javierveras/projectav-telemetry-pdb-2026/hardware/parts-list/imaginary-engineering-v0-bjcbuq6lzvt41.webp

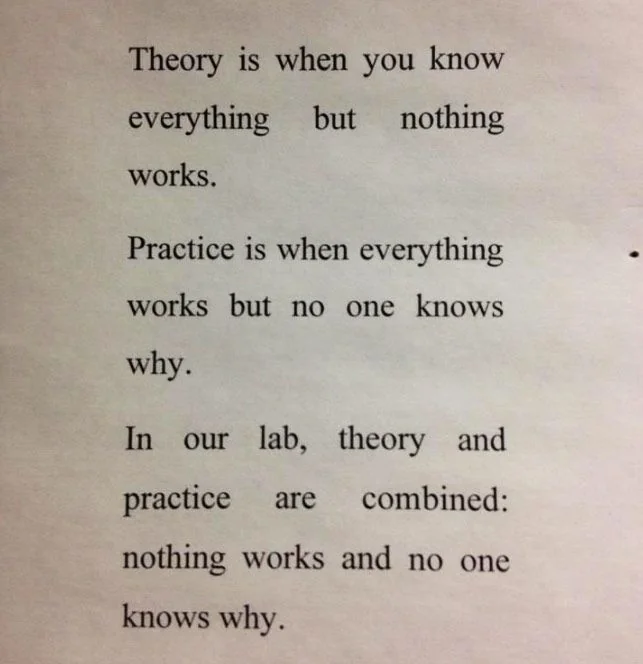
hardware/parts-list/imaginary-engineering-v0-bjcbuq6lzvt41.webp
