javierveras/projectav-telemetry-pdb-2026/hardware/refferences/selected-parts/Screenshot 2026-09-05 142607.png

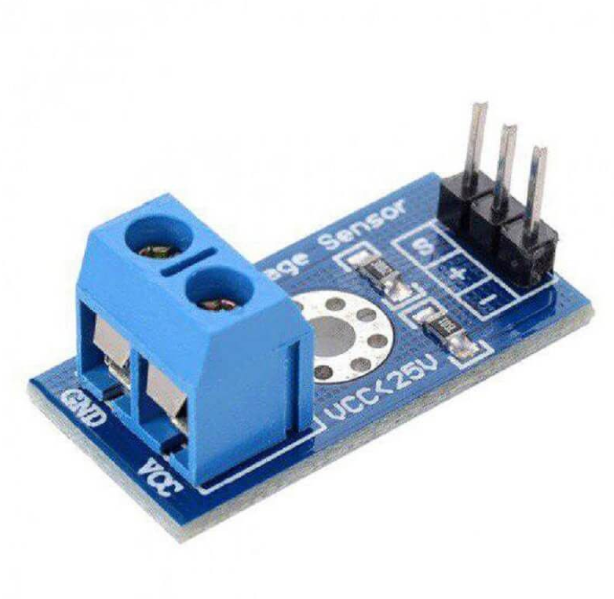
hardware/refferences/selected-parts/Screenshot 2026-09-05 142607.png
