javierveras/projectav-telemetry-pdb-2026/README.md

# Telemetry & Power Distribution System
Our power distribution and telemetry system's hardware, firmware, and technical documentation.
