javierveras/projectav-telemetry-pdb-2026/hardware/mark-II/telemetry-motherboard/data.xlsx

Wheels
Max Wheel Current (A)
15.00
Minnimum Trace Width (top, 2oz), (mm)
7.00
 | e
