javierveras/projectav-telemetry-pdb-2026/docs/gui-concept.png

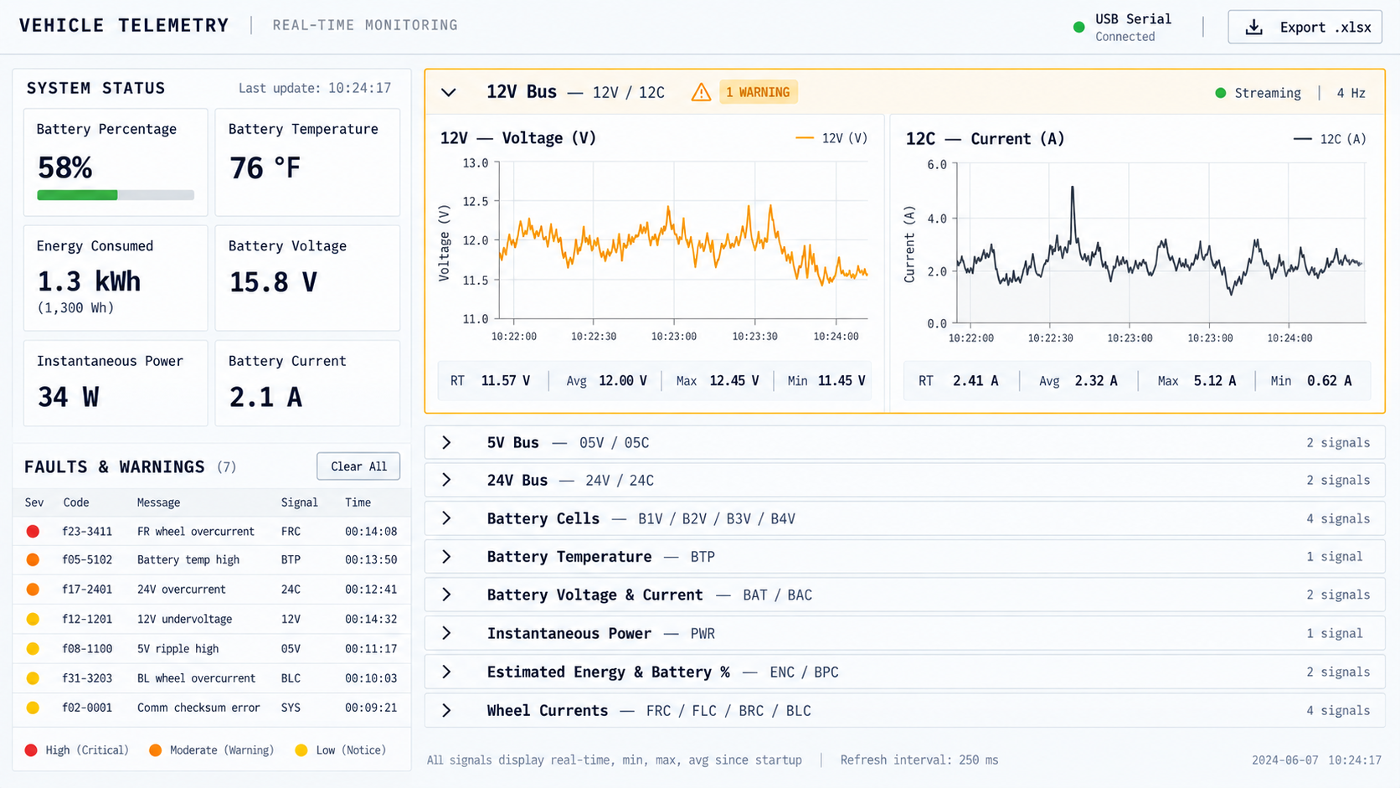
docs/gui-concept.png
