javierveras/projectav-telemetry-pdb-2026/hardware/refferences/projectav-refferences/bms.png

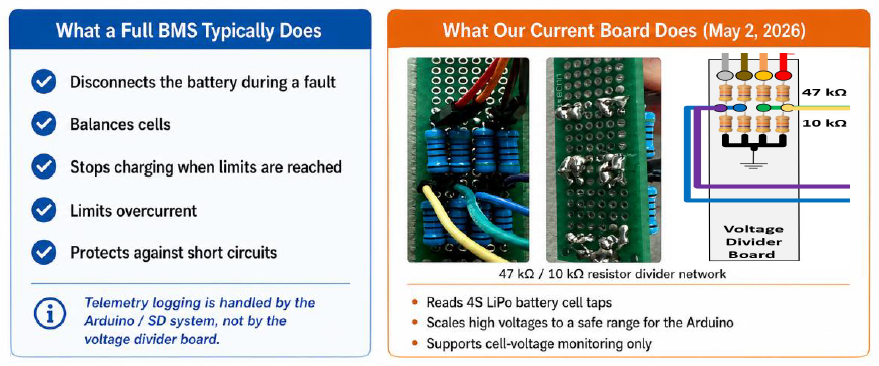
hardware/refferences/projectav-refferences/bms.png
