javierveras/projectav-telemetry-pdb-2026/hardware/refferences/projectav-refferences/jumbletron.jpeg

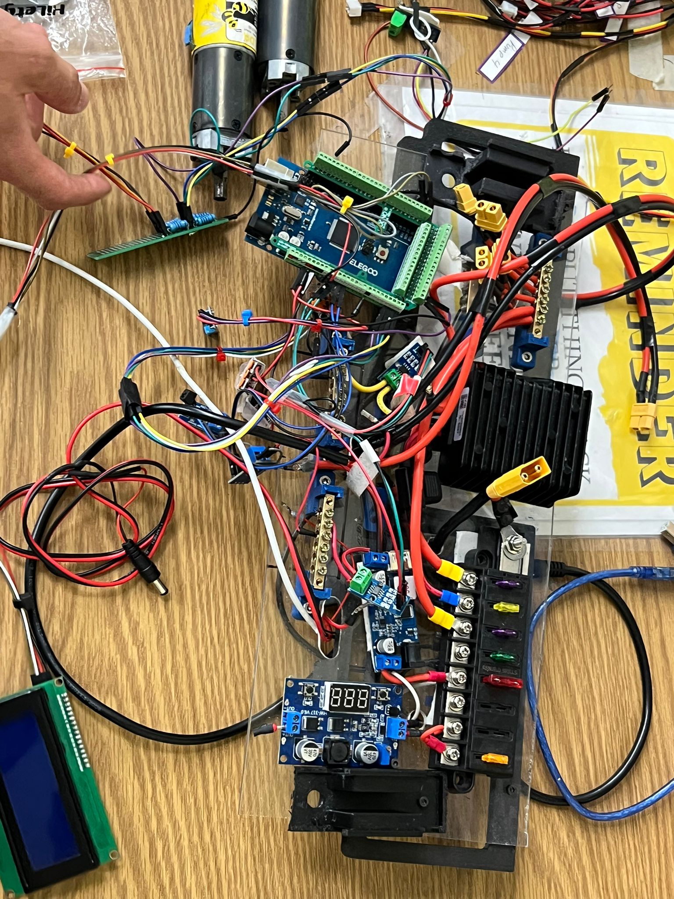
hardware/refferences/projectav-refferences/jumbletron.jpeg
