javierveras/projectav-telemetry-pdb-2026/hardware/bms/bms/excel/Sample-BOM_JLCSMT.xlsx

Comment | Designator | Footprint | JLCPCB Part #（optional）
27K | RTOP1,RTOP2,RTOP3,RTOP4 | R_0805_2012Metric
10K | RBOT1,RBOT2,RBOT3,RBOT4,RBZRPULL | R_0805_2012Metric
680 | RLED1,RLED2,RLED3,RLED4 | R_0805_2012Metric
1K | RBZR | R_0805_2012Metric
Q_NPN_BEC | Q1 | SOT-23
LED | D1,D2,D3,D4 | LED_0805_2012Metric
