javierveras/projectav-telemetry-pdb-2026/hardware/parts-list/5ytykg0xvrzd1.jpeg

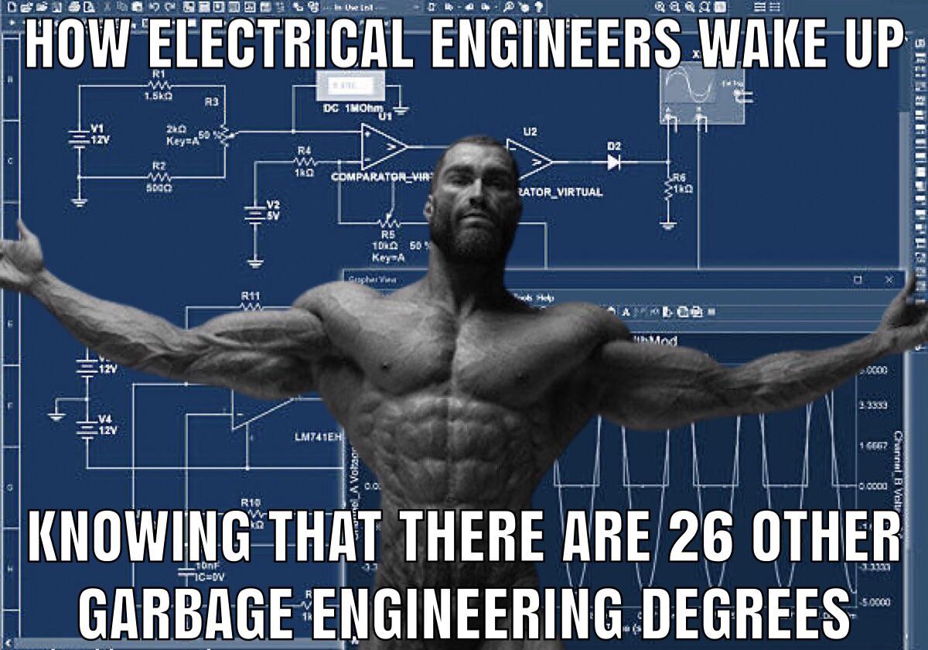
hardware/parts-list/5ytykg0xvrzd1.jpeg
