javierveras/projectav-telemetry-pdb-2026/hardware/parts-list/31UVr6PlqkL.jpg

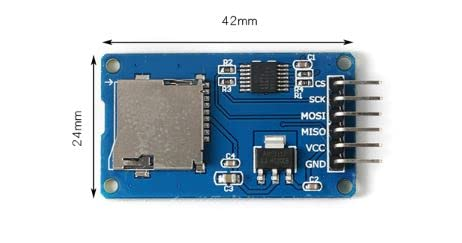
hardware/parts-list/31UVr6PlqkL.jpg
