javierveras/projectav-telemetry-pdb-2026/hardware/refferences/selected-parts/power_input.png

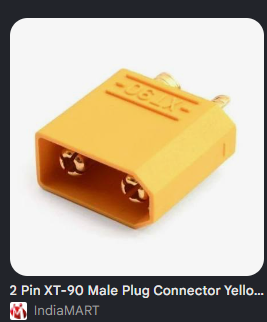
hardware/refferences/selected-parts/power_input.png
