javierveras/projectav-telemetry-pdb-2026/hardware/refferences/selected-parts/power_outputs.png

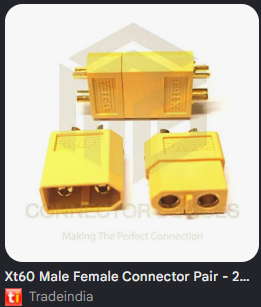
hardware/refferences/selected-parts/power_outputs.png
