javierveras/projectav-telemetry-pdb-2026/hardware/refferences/kicad-refferences/PDB/csense/ACS772ECB-400B-PFF-T.step

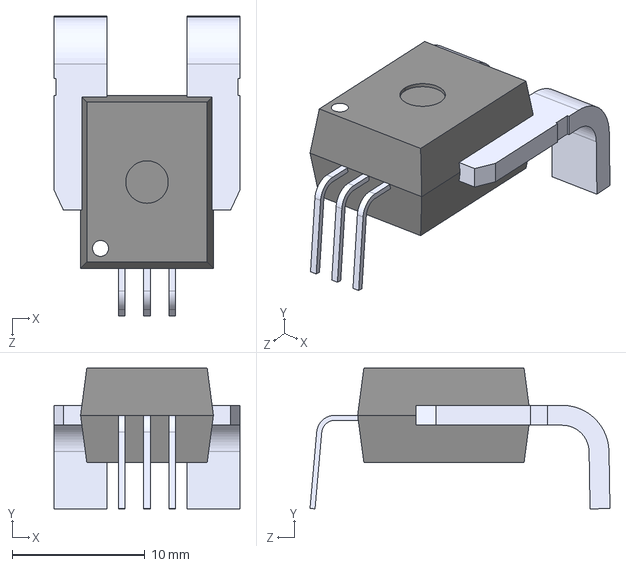
[picture p85: CAD file, 2026-09-18]
hardware/refferences/kicad-refferences/PDB/csense/ACS772ECB-400B-PFF-T.step
14.0 x 10.6 x 22.6 mm
