javierveras/projectav-telemetry-pdb-2026/hardware/refferences/kicad-refferences/PDB/XT90/XT90PW-F/3D/XT90PW-F.stp

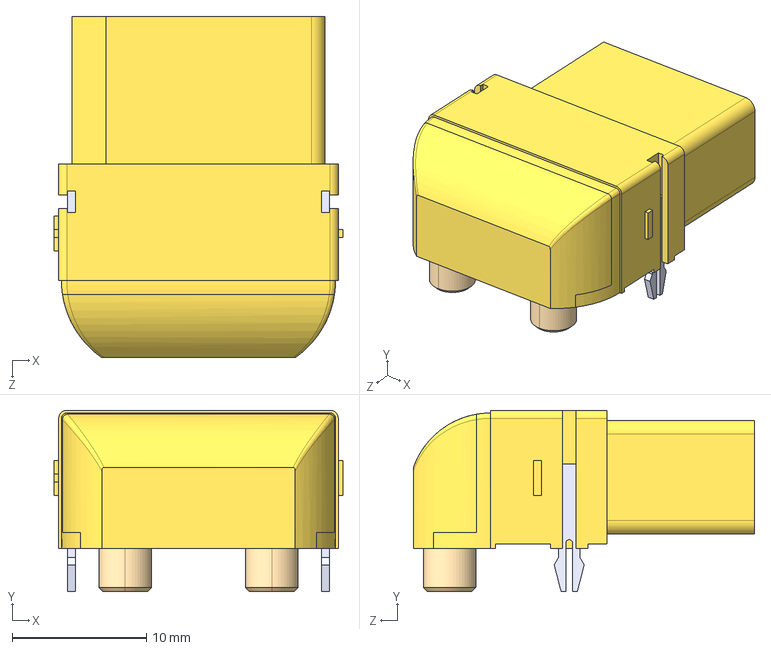
[picture p86: CAD file, 2026-09-18]
hardware/refferences/kicad-refferences/PDB/XT90/XT90PW-F/3D/XT90PW-F.stp
21.5 x 13.5 x 25.4 mm
