javierveras/projectav-telemetry-pdb-2026/hardware/refferences/kicad-refferences/PDB/external_symbols/XT30PW-F.step

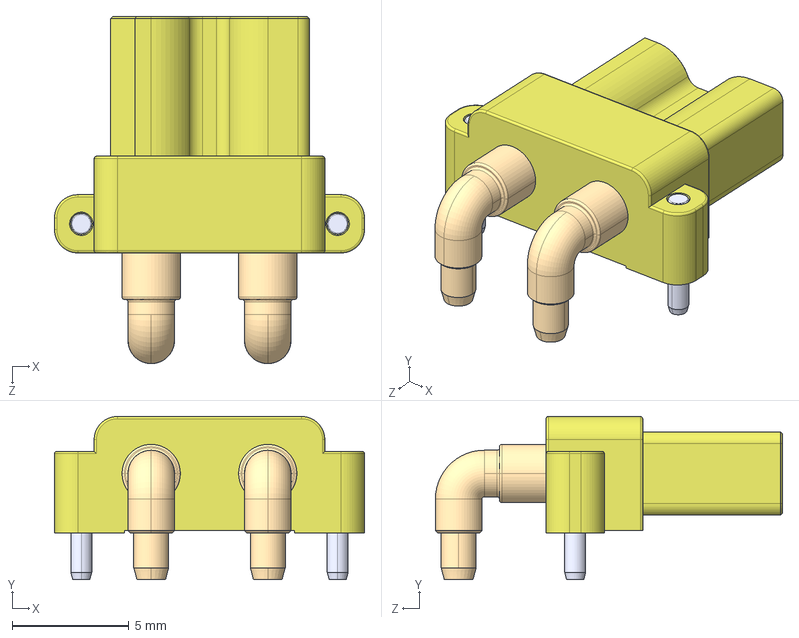
[picture p87: CAD file, 2026-09-18]
hardware/refferences/kicad-refferences/PDB/external_symbols/XT30PW-F.step
13.3 x 7.00 x 14.9 mm
