javierveras/projectav-telemetry-pdb-2026/hardware/refferences/kicad-refferences/PDB/external_symbols/LTC3114EFE-1_PBF.step

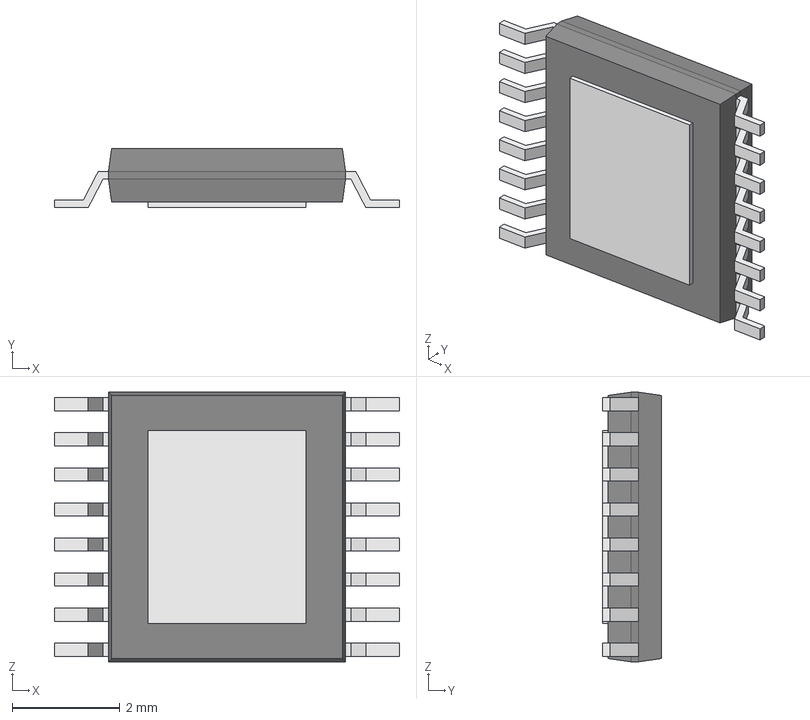
[picture p88: CAD file, 2026-09-18]
hardware/refferences/kicad-refferences/PDB/external_symbols/LTC3114EFE-1_PBF.step
6.40 x 1.10 x 5.00 mm
Body001 (Mirror #1) x 8
