javierveras/projectav-telemetry-pdb-2026/hardware/refferences/kicad-refferences/PDB/external_symbols/XT90PW-M.step

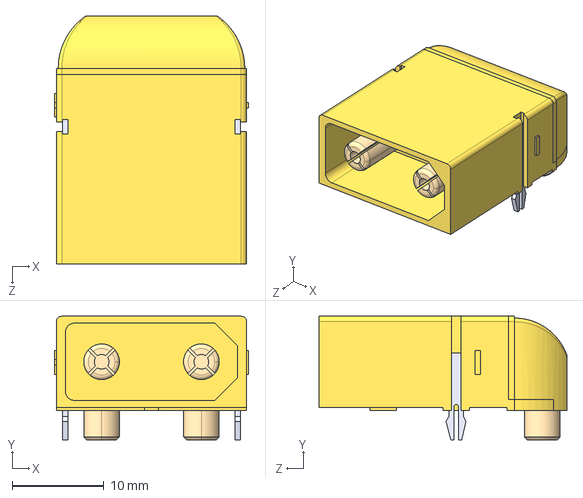
[picture p89: CAD file, 2026-09-18]
hardware/refferences/kicad-refferences/PDB/external_symbols/XT90PW-M.step
21.2 x 13.5 x 27.1 mm
