javierveras/projectav-telemetry-pdb-2026/hardware/refferences/kicad-refferences/PDB/external_symbols/TA08-81GWA.step

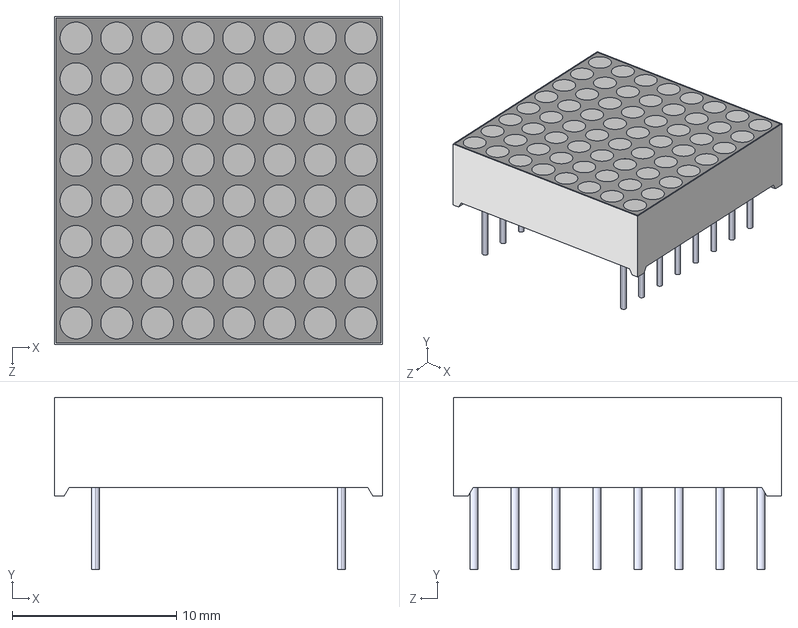
[picture p90: CAD file, 2026-09-18]
hardware/refferences/kicad-refferences/PDB/external_symbols/TA08-81GWA.step
20.0 x 10.5 x 20.0 mm
