javierveras/projectav-telemetry-pdb-2026/hardware/refferences/kicad-refferences/PDB/external_symbols/LI0603G121R-10.step

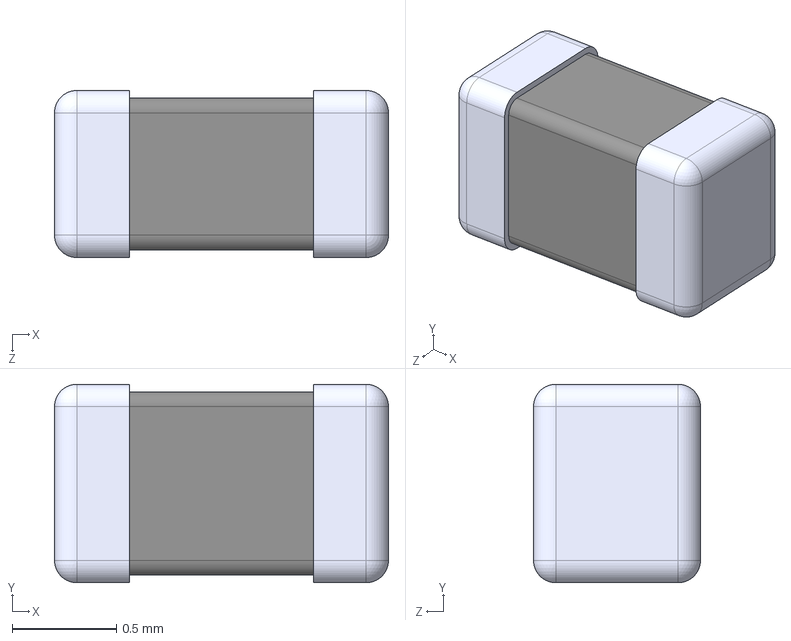
[picture p91: CAD file, 2026-09-18]
hardware/refferences/kicad-refferences/PDB/external_symbols/LI0603G121R-10.step
1.60 x 0.95 x 0.8 mm
