javierveras/projectav-telemetry-pdb-2026/hardware/refferences/kicad-refferences/PDB/external_symbols/AOZ1284PI.step

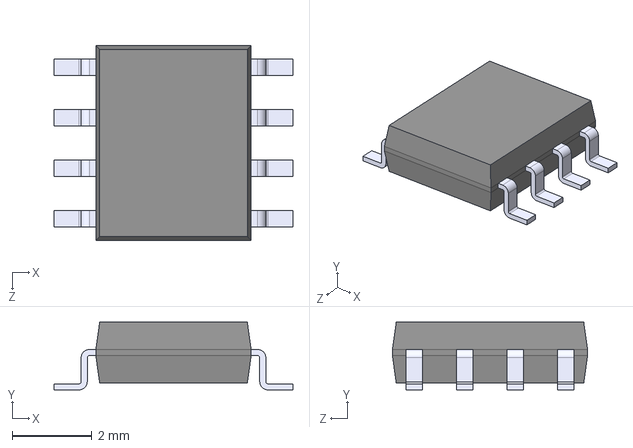
[picture p92: CAD file, 2026-09-18]
hardware/refferences/kicad-refferences/PDB/external_symbols/AOZ1284PI.step
6.00 x 1.70 x 4.90 mm
