javierveras/projectav-telemetry-pdb-2026/hardware/refferences/kicad-refferences/PDB/external_symbols/JS202011SCQN.step

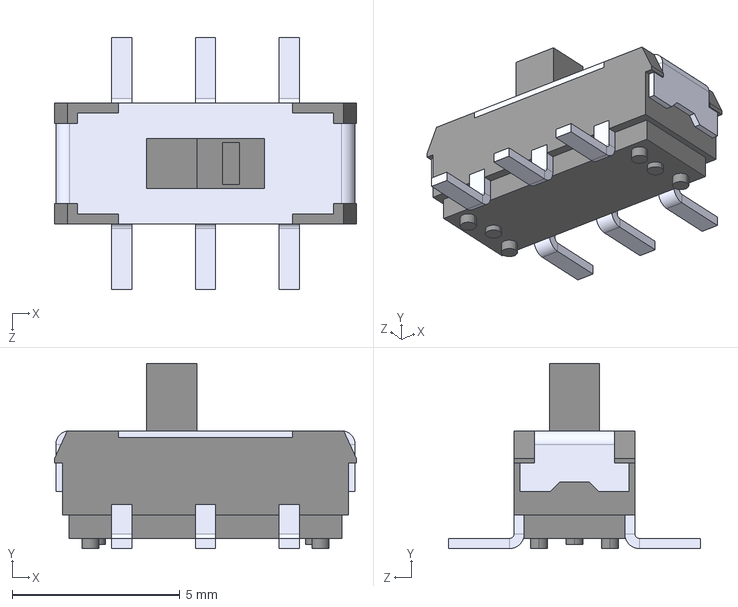
[picture p93: CAD file, 2026-09-18]
hardware/refferences/kicad-refferences/PDB/external_symbols/JS202011SCQN.step
8.99 x 5.51 x 7.49 mm
