javierveras/projectav-telemetry-pdb-2026/hardware/refferences/kicad-refferences/PDB/TLV75533PDBVR/TLV75533PDBVR.step

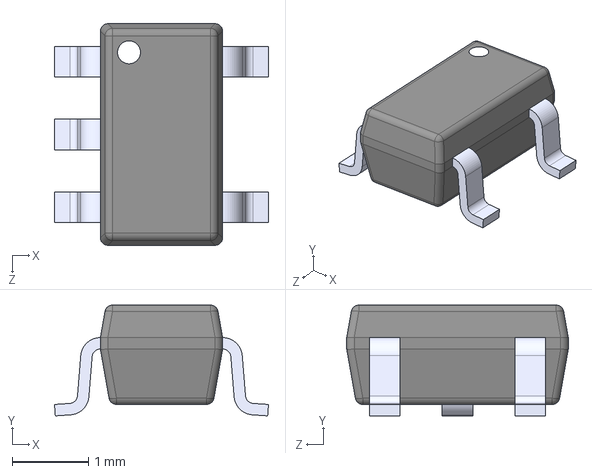
[picture p94: CAD file, 2026-09-18]
hardware/refferences/kicad-refferences/PDB/TLV75533PDBVR/TLV75533PDBVR.step
2.80 x 1.45 x 2.90 mm
