javierveras/projectav-telemetry-pdb-2026/(list of files, cad)

Other CAD files:
hardware/refferences/kicad-refferences/PDB/XT90/XT90PW-F/Allegro/xt90pwf.psm
hardware/refferences/kicad-refferences/PDB/XT90/XT90PW-F/DEHDL/xt90pw_f/chips/chips.prt
