javierveras/projectav-telemetry-pdb-2026/hardware/refferences/projectav-refferences/Electrical System Wiring & Design.pdf

# Antenna

# ESC Mount

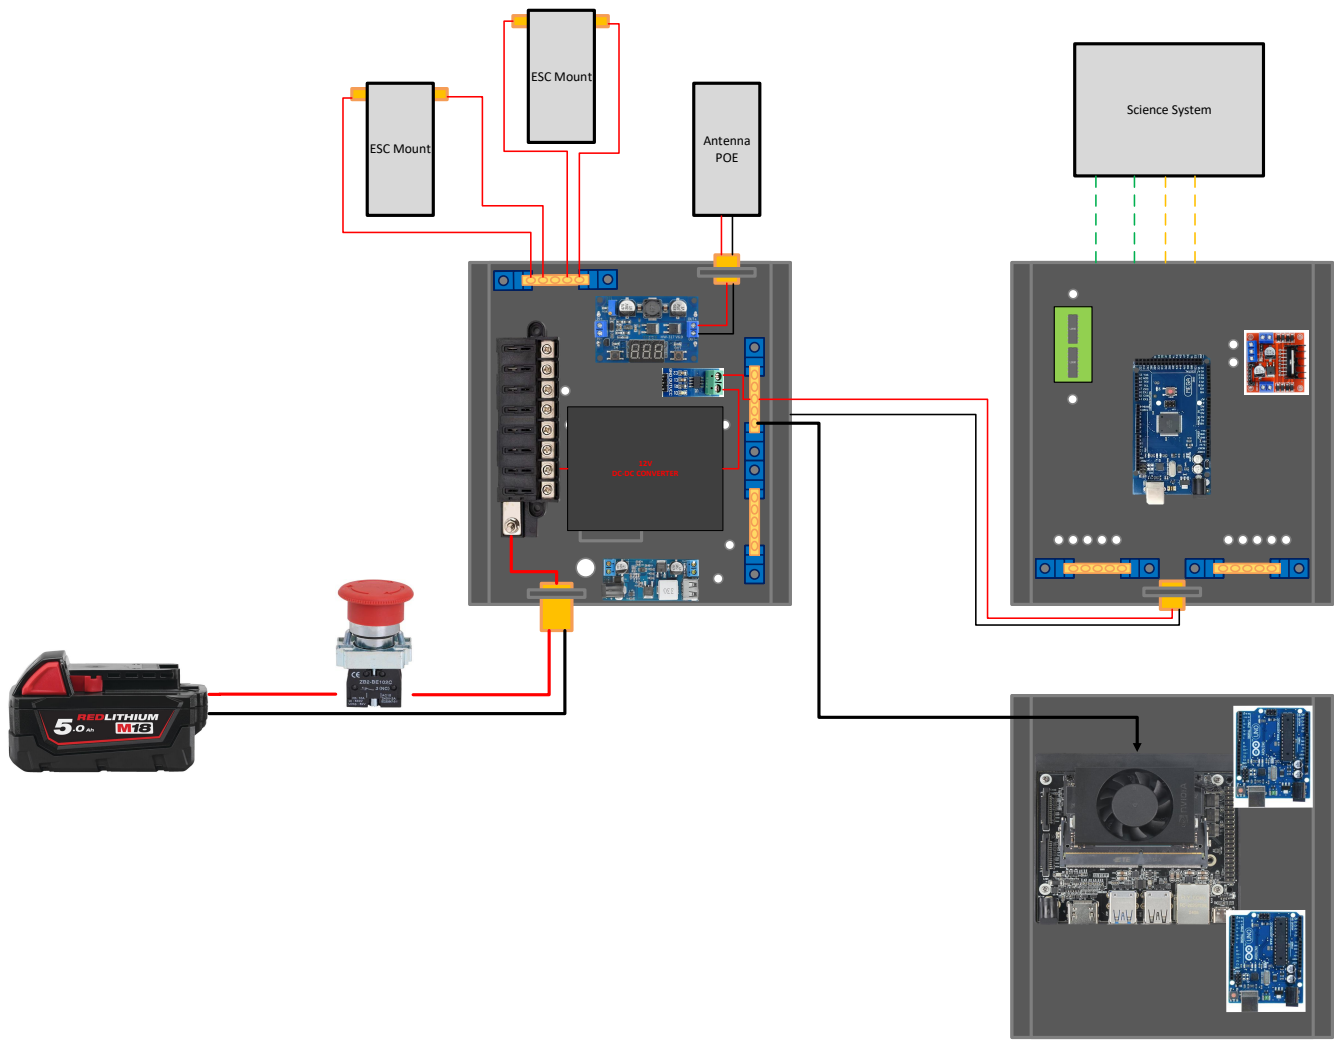
[picture p107: page 1]
Converter; POE; ESC Mount; Science System

DC-DC CONVERTER

Inductor Housing for 12V
