javierveras/projectav-telemetry-pdb-2026/hardware/refferences/projectav-refferences/One-Line Diagram_Rev1.pdf

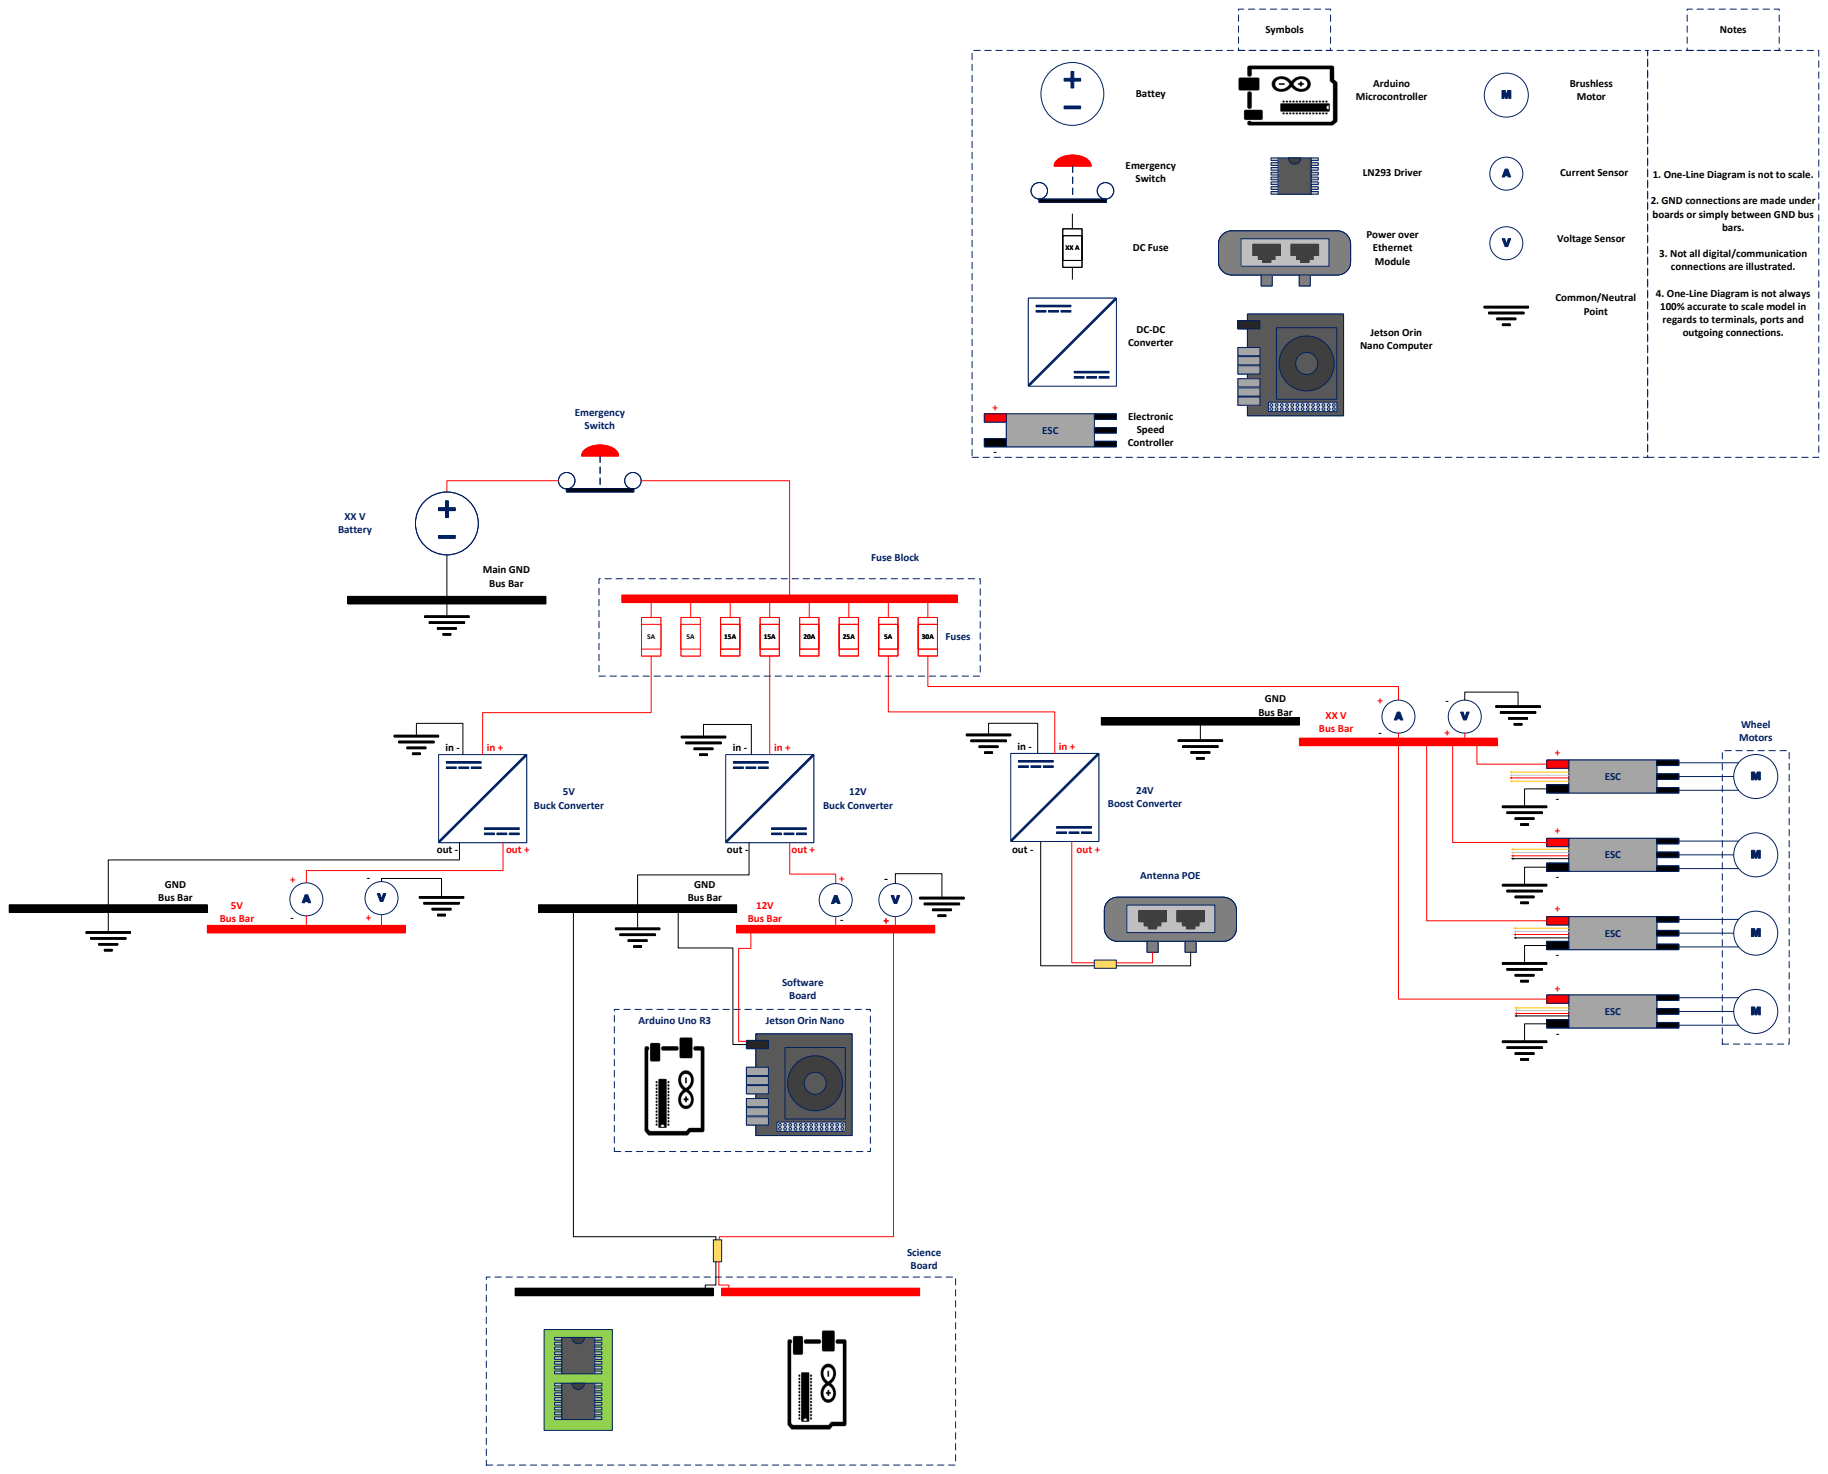
[picture p108: page 1]
ESC; 5V Buck Converter; 12V Buck Converter; 24V Boost Converter; XX V Battery; Emergency Switch; Fuse Block; Main GND Bus Bar; GND Bus Bar; out -; out +; 5V Bus Bar; 12V Bus Bar; Fuses; Wheel Motors; Antenna POE; Software Board; Arduino Uno R3; XX V Bus Bar; Science Board; Symbols; Battey; DC Fuse; DC-DC Converter; Electronic Speed Controller; Arduino Microcontroller; Jetson Orin Nano Computer; LN293 Driver; Power over Ethernet Module; Brushless Motor; Current Sensor; Voltage Sensor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

1. One-Line Diagram is not to scale.

2. GND connections are made under
boards or simply between GND bus

3. Not all digital/communication
connections are illustrated.

4. One-Line Diagram is not always
100% accurate to scale model in
regards to terminals, ports and
outgoing connections.

Jetson Orin Nano
