javierveras/projectav-telemetry-pdb-2026/(list of files, drawings)

Other design files:
hardware/refferences/kicad-refferences/PDB/XT90/XT90PW-F/Altium/XT90PW-F.SchLib
hardware/refferences/kicad-refferences/PDB/XT90/XT90PW-F/Altium/XT90PWF.PcbLib
