javierveras/projectav-telemetry-pdb-2026/hardware/mark-III/telemetry-motherboard/telemetry_mark_I.kicad_pcb

## KiCad design hardware/mark-III/telemetry-motherboard/telemetry_mark_I.kicad_pcb (2026-10-28)

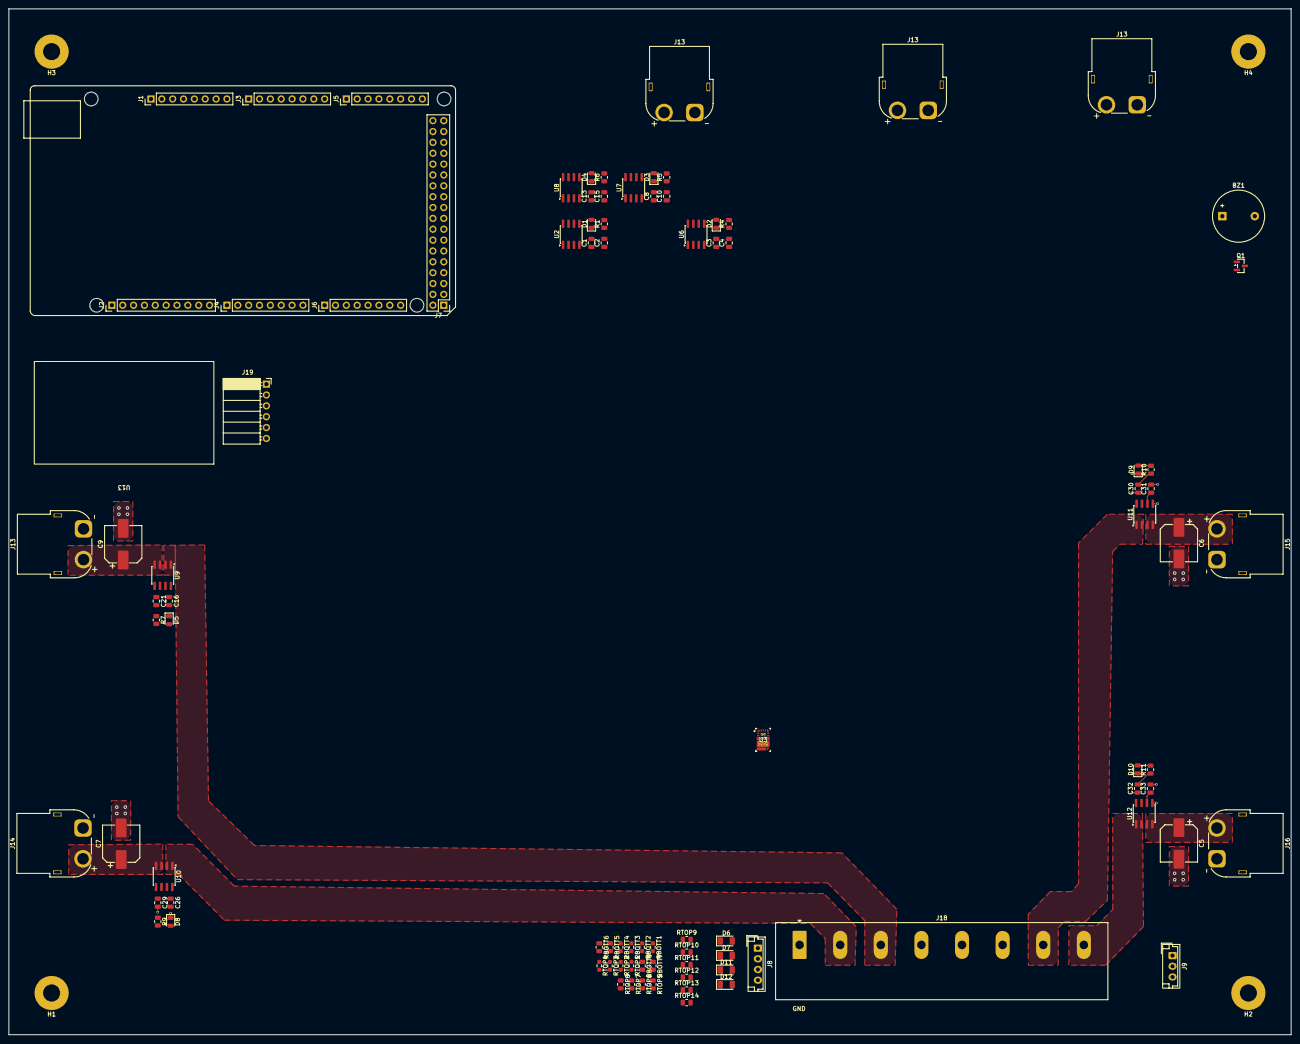
[picture p109: board hardware/mark-III/telemetry-motherboard/telemetry_mark_I.kicad_pcb from above]

Board: 4 copper layers, 300.0 x 240.0 mm, 101 parts (0 on the bottom side), 58 nets.

Parts:
BZ1: Buzzer; Buzzer_12x9.5RM7.6
C1, C3, C8, C13, C16, C26, C30, C32: 100nF; C_0805_2012Metric
C2, C4, C10, C15, C21, C29, C31, C33: 1nF; C_0805_2012Metric
C5, C6, C7, C9: C_Polarized; CP_Elec_8x10.5
D1, D2, D3, D4, D5, D8, D9, D10: LED; LED_0805_2012Metric
D6, D7, D11, D12: LED; LED_1206_3216Metric
H1, H2, H3, H4: MountingHole; MountingHole_4mm_Pad
J1: Power; PinHeader_1x08_P2.54mm_Vertical
J2: PWM; PinHeader_1x10_P2.54mm_Vertical
J3, J5: Analog; PinHeader_1x08_P2.54mm_Vertical
J4: PWM; PinHeader_1x08_P2.54mm_Vertical
J6: Communication; PinHeader_1x08_P2.54mm_Vertical
J7: Digital; PinHeader_2x18_P2.54mm_Vertical
J8: INPUT_CELL1; JST_EH_B4B-EH-A_1x04_P2.50mm_Vertical
J9: Temp_Sensor_Header; JST_EH_B3B-EH-A_1x03_P2.50mm_Vertical
J13, J13#2, J13#3, J13#4, J14, J15, J16: Conn_01x02_Socket; AMASS_XT60PW-F_1x02_P7.20mm_Horizontal
J18: Screw_Terminal_01x08; TerminalBlock_Ningbo-Kagnex_HB9500_1x08_P9.5mm
J19: Conn_01x06_Pin; PinSocket_1x06_P2.54mm_Horizontal
MH1, MH2, MH5, MH6: MountingHole_3.2mm
Q1: Q_NPN_BEC; SOT-23
R1, R4, R5, R6, R7, R9, R10, R11: 1k; R_0805_2012Metric
RBOTT1, RBOTT2, RBOTT3, RBOTT4: 2k; R_0603_1608Metric_Pad0.98x0.95mm_HandSolder
RBOTT5, RBOTT6, RBOTT7, RBOTT8: 10K; R_0805_2012Metric
RTOP1, RTOP2, RTOP3, RTOP4: 18k; R_0603_1608Metric_Pad0.98x0.95mm_HandSolder
RTOP5, RTOP6, RTOP7, RTOP8: 47K; R_0805_2012Metric
RTOP9, RTOP12, RTOP13, RTOP14: 680; R_0805_2012Metric
RTOP10: 1k; R_0805_2012Metric
RTOP11: 10k; R_0805_2012Metric
U1: ArduinoMega
U2, U6, U7, U8, U9, U10, U11, U12: ACS712xLCTR-05B; SOIC-8_3.9x4.9mm_P1.27mm
U3: TPS543B25VRYSR; RYS0017A-MFG
U13: Untitled_3

Connections:
5V_MEASS: J9.1, RTOP4.1, U2.3 (IP-), U2.4 (IP-)
12V_MEASS: RTOP1.1, U6.3 (IP-), U6.4 (IP-)
24V_MEASS: RTOP2.1, U7.3 (IP-), U7.4 (IP-)
+5V: C1.2, C3.2, C8.2, C13.2, C16.2, C26.2, C30.2, C32.2, J1.5, J7.35, J7.36, R1.1, R4.1, R5.1, R6.1, R7.1, R9.1, R10.1, R11.1, U2.1 (IP+), U2.2 (IP+), U2.8 (VCC), U6.8 (VCC), U7.8 (VCC), U8.8 (VCC), U9.8 (VCC), U10.8 (VCC), U11.8 (VCC), U12.8 (VCC)
/5V_CURRENT: J3.1, U2.7 (VIOUT)
/5V_VOLTAGE: RBOTT4.1, RTOP4.2
/12V_CURRENT: J3.2, U6.7 (VIOUT)
/12V_VOLTAGE: RBOTT1.1, RTOP1.2
/24V_CURRENT: J3.3, U7.7 (VIOUT)
/24V_VOLTAGE: RBOTT2.1, RTOP2.2
/+12V: U6.1 (IP+), U6.2 (IP+)
/+24V: U7.1 (IP+), U7.2 (IP+)
/BATT_CURRENT: J3.4, U8.7 (VIOUT)
/BATT_VOLTAGE: RBOTT3.1, RTOP3.2
/BMS/MEASS_CELL1: RBOTT5.1, RTOP5.2
/BMS/MEASS_CELL2: RBOTT7.1, RTOP7.2
/BMS/MEASS_CELL3: RBOTT6.1, RTOP6.2
/BMS/MEASS_CELL4: RBOTT8.1, RTOP8.2
/RAW_BATT(15-ESCs): U8.1 (IP+), U8.2 (IP+)
/RAW_BATT(15-W1): J18.3, U9.1 (IP+), U9.2 (IP+)
/RAW_BATT(15-W2): J18.2, U10.1 (IP+), U10.2 (IP+)
/RAW_BATT(15-W3): J18.7, U11.1 (IP+), U11.2 (IP+)
/RAW_BATT(15-W4): J18.8, U12.1 (IP+), U12.2 (IP+)
/SCL/21: J2.1, J6.8
/SDA/20: J2.2, J6.7
/TEMP_READING: J3.5, J9.2
/W1_MEASS: C9.1, J13.2, J13#4.2, U9.3 (IP-), U9.4 (IP-)
/W2_MEASS: C7.1, J14.2, U10.3 (IP-), U10.4 (IP-)
/W3_MEASS: C6.1, J15.2, U11.3 (IP-), U11.4 (IP-)
/W4_MEASS: C5.1, J16.2, U12.3 (IP-), U12.4 (IP-)
BATT_MEASS: RTOP3.1, U8.3 (IP-), U8.4 (IP-)
GND: C1.1, C2.2, C3.1, C4.2, C5.2, C6.2, C7.2, C8.1, C9.2, C10.2, C13.1, C15.2, C16.1, C21.2, C26.1, C29.2, C30.1, C31.2, C32.1, C33.2, D1.1 (K), D2.1 (K), D3.1 (K), D4.1 (K), D5.1 (K), D6.1 (K), D7.1 (K), D8.1 (K), D9.1 (K), D10.1 (K), D11.1 (K), D12.1 (K), J1.6, J1.7, J2.4, J7.1, J7.2, J9.3, J13.1, J13#4.1, J14.1, J15.1, J16.1, J18.1, Q1.2 (E), RBOTT1.2, RBOTT2.2, RBOTT3.2, RBOTT4.2, RBOTT5.2, RBOTT6.2, RBOTT7.2, RBOTT8.2, RTOP11.1, U2.5 (GND), U6.5 (GND), U7.5 (GND), U8.5 (GND), U9.5 (GND), U10.5 (GND), U11.5 (GND), U12.5 (GND)
unnamed: BZ1.2 (-), Q1.3 (C)
unnamed: D1.2 (A), R1.2
unnamed: D2.2 (A), R4.2
unnamed: D3.2 (A), R5.2
unnamed: D4.2 (A), R6.2
unnamed: D5.2 (A), R7.2
unnamed: D6.2 (A), RTOP9.2
unnamed: D7.2 (A), RTOP13.2
unnamed: D8.2 (A), R9.2
unnamed: D9.2 (A), R10.2
unnamed: D10.2 (A), R11.2
unnamed: D11.2 (A), RTOP12.2
unnamed: D12.2 (A), RTOP14.2
unnamed: Q1.1 (B), RTOP10.2, RTOP11.2
unnamed: C2.1, U2.6 (FILTER)
unnamed: C4.1, U6.6 (FILTER)
unnamed: C10.1, U7.6 (FILTER)
unnamed: C15.1, U8.6 (FILTER)
unnamed: C21.1, U9.6 (FILTER)
unnamed: C29.1, U10.6 (FILTER)
unnamed: C31.1, U11.6 (FILTER)
unnamed: C33.1, U12.6 (FILTER)
RAW_CELL1: J8.1, RTOP5.1
RAW_CELL2: J8.2, RTOP7.1
RAW_CELL3: J8.3, RTOP6.1
RAW_CELL4: J8.4, RTOP8.1
