javierveras/projectav-telemetry-pdb-2026/hardware/bms/bms/bms/bms.kicad_pcb

## KiCad design hardware/bms/bms/bms/bms.kicad_pcb (2026-10-14)

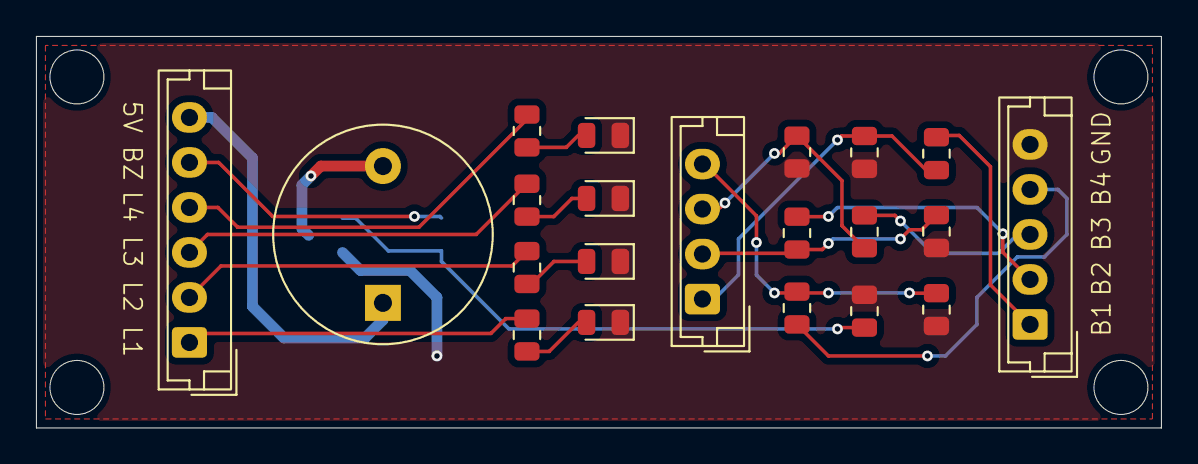
[picture p110: board bms.kicad_pcb from above]

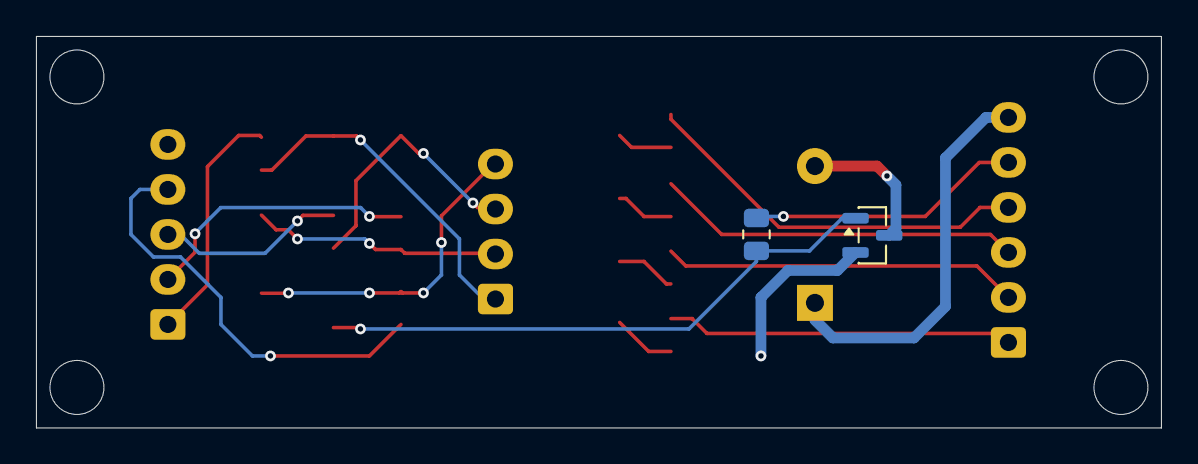
[picture p111: board bms.kicad_pcb from below]

Board: 2 copper layers, 62.5 x 21.8 mm, 23 parts (2 on the bottom side), 21 nets.

Parts:
BZ1: Buzzer; Buzzer_12x9.5RM7.6
D1, D2, D3, D4: LED; LED_0805_2012Metric
J1: OUTPUT; JST_EH_B4B-EH-A_1x04_P2.50mm_Vertical
J2: Conn_01x05_Pin; JST_EH_B5B-EH-A_1x05_P2.50mm_Vertical
J3: Conn_01x06_Pin; JST_EH_B6B-EH-A_1x06_P2.50mm_Vertical
Q1: Q_NPN_BEC; SOT-23
RBOTT5, RBOTT6, RBOTT7, RBOTT8: 10K; R_0805_2012Metric
RTOP5, RTOP6, RTOP7, RTOP8: 47K; R_0805_2012Metric
RTOP9, RTOP12, RTOP13, RTOP14: 680; R_0805_2012Metric
RTOP10: 1k; R_0805_2012Metric
RTOP11: 10k; R_0805_2012Metric

Connections:
/5V: BZ1.1 (+), J3.6
/BUZZER_GATE: J3.5, RTOP10.1
/LED1: J3.1, RTOP9.1
/LED2: J3.2, RTOP13.1
/LED3: J3.3, RTOP14.1
/LED4: J3.4, RTOP12.1
/MEASS_CELL1: J1.1, RBOTT5.1, RTOP5.2
/MEASS_CELL2: J1.2, RBOTT7.1, RTOP7.2
/MEASS_CELL3: J1.3, RBOTT6.1, RTOP6.2
/MEASS_CELL4: J1.4, RBOTT8.1, RTOP8.2
GND: D1.1 (K), D2.1 (K), D3.1 (K), D4.1 (K), J2.5, Q1.2 (E), RBOTT5.2, RBOTT6.2, RBOTT7.2, RBOTT8.2, RTOP11.1
unnamed: BZ1.2 (-), Q1.3 (C)
unnamed: D1.2 (A), RTOP9.2
unnamed: D2.2 (A), RTOP12.2
unnamed: D3.2 (A), RTOP13.2
unnamed: D4.2 (A), RTOP14.2
unnamed: Q1.1 (B), RTOP10.2, RTOP11.2
RAW_CELL1: J2.1, RTOP5.1
RAW_CELL2: J2.2, RTOP7.1
RAW_CELL3: J2.3, RTOP6.1
RAW_CELL4: J2.4, RTOP8.1
