javierveras/projectav-telemetry-pdb-2026/hardware/refferences/kicad-refferences/PDB/pdb.kicad_pcb

## KiCad design hardware/refferences/kicad-refferences/PDB/pdb.kicad_pcb (2026-09-18)

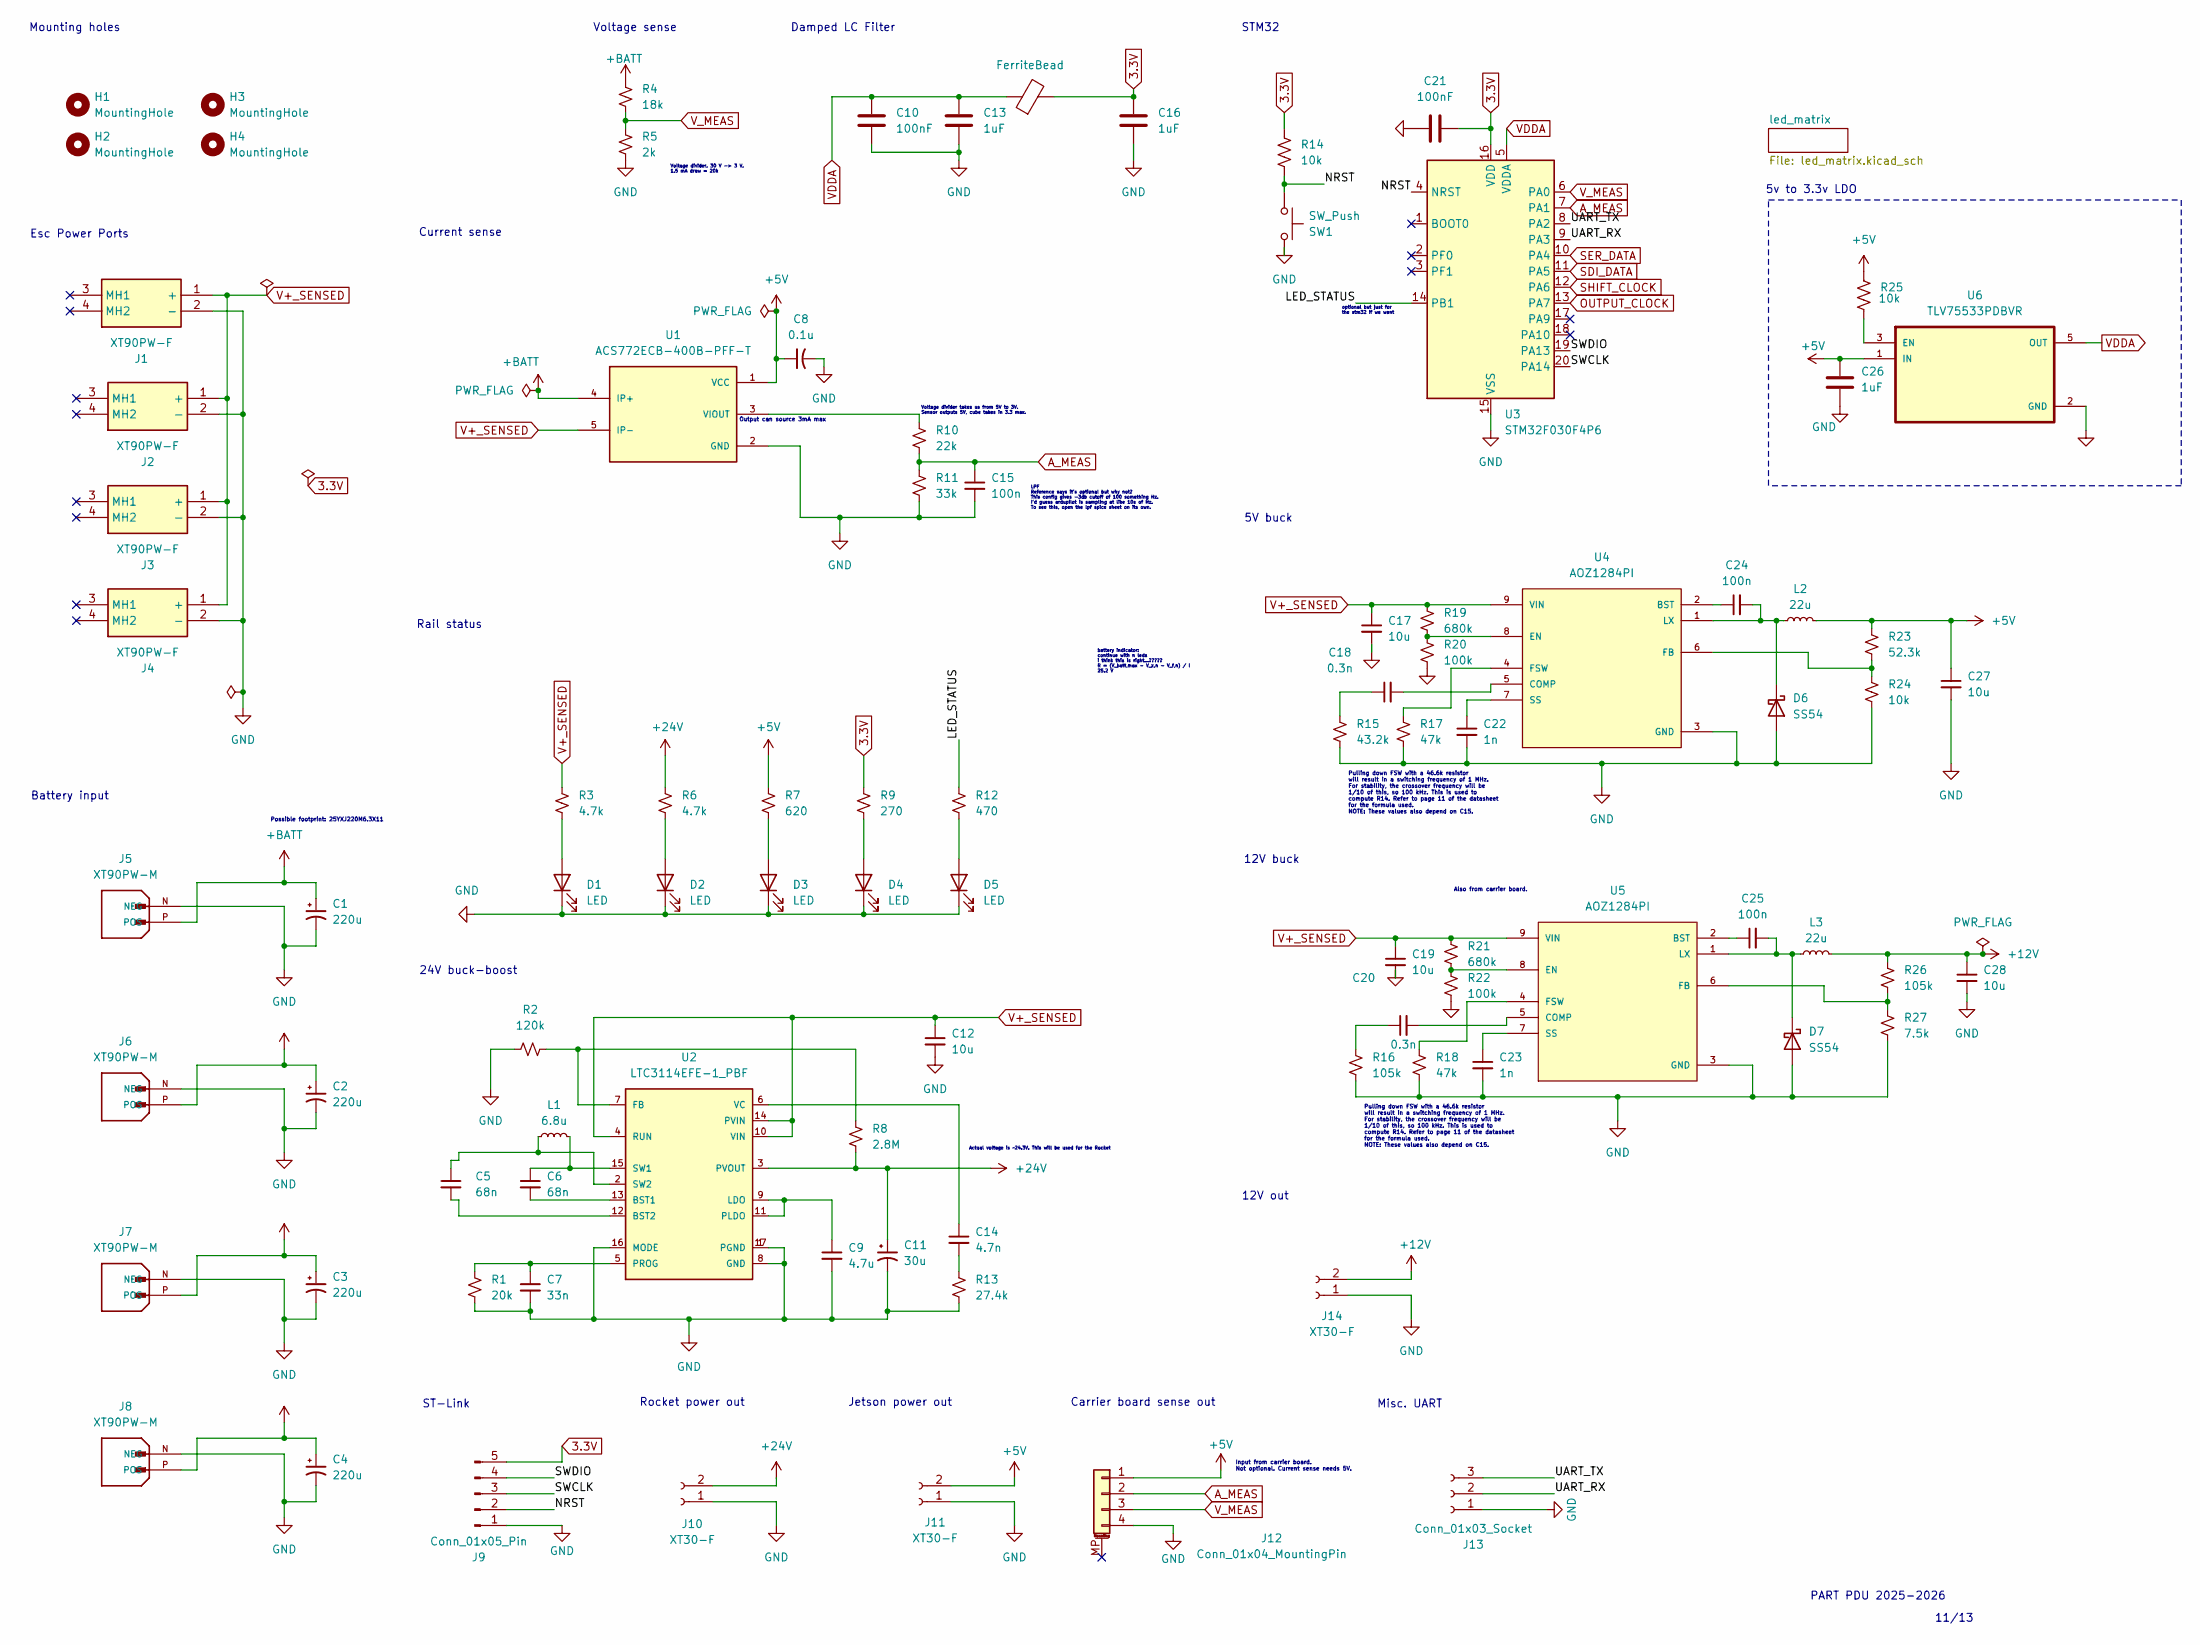
[picture p112: schematic pdb.kicad_sch]

Parts:
C1, C2, C3, C4: 220u; CP_Elec_8x10
C5, C6: 68n; C_0603_1608Metric_Pad1.08x0.95mm_HandSolder
C7: 33n; C_0603_1608Metric_Pad1.08x0.95mm_HandSolder
C8: 0.1u; C_0603_1608Metric_Pad1.08x0.95mm_HandSolder
C9: 4.7u; C_0603_1608Metric_Pad1.08x0.95mm_HandSolder
C10, C21: 100nF; C_0603_1608Metric_Pad1.08x0.95mm_HandSolder
C11: 30u; CP_Radial_D5.0mm_P2.00mm
C12, C17, C19, C27, C28: 10u; C_0603_1608Metric_Pad1.08x0.95mm_HandSolder
C13, C16, C26: 1uF; C_0603_1608Metric_Pad1.08x0.95mm_HandSolder
C14: 4.7n; C_0603_1608Metric_Pad1.08x0.95mm_HandSolder
C15, C24, C25: 100n; C_0603_1608Metric_Pad1.08x0.95mm_HandSolder
C18, C20: 0.3n; C_0603_1608Metric_Pad1.08x0.95mm_HandSolder
C22, C23: 1n; C_0603_1608Metric_Pad1.08x0.95mm_HandSolder
D1, D2, D3, D4, D5: LED; LED_0603_1608Metric_Pad1.05x0.95mm_HandSolder
D6, D7: SS54; D_SMA
FB1: FerriteBead; FB_LI0603G121R-10
H1, H2, H3, H4: MountingHole; MountingHole_4mm_Pad
J1, J2, J3, J4: XT90PW-F; XT90PWF; Manufacturer_Part_Number XT90PW-F
J5, J6, J7, J8: XT90PW-M; AMASS_XT90PW-M; PARTREV V00
J9: Conn_01x05_Pin; PinHeader_1x05_P2.54mm_Vertical
J10, J11, J14: XT30-F; AMASS_XT30PW-F
J12: Conn_01x04_MountingPin; JST_GH_SM04B-GHS-TB_1x04-1MP_P1.25mm_Horizontal
J13: Conn_01x03_Socket; PinSocket_1x03_P2.54mm_Vertical
L1: 6.8u; L_0603_1608Metric_Pad1.05x0.95mm_HandSolder
L2, L3: 22u; L_12x12mm_H8mm
R1: 20k; R_0603_1608Metric_Pad0.98x0.95mm_HandSolder
R2: 120k; R_0603_1608Metric_Pad0.98x0.95mm_HandSolder
R3, R6: 4.7k; R_0603_1608Metric_Pad0.98x0.95mm_HandSolder
R4: 18k; R_0603_1608Metric_Pad0.98x0.95mm_HandSolder
R5: 2k; R_0603_1608Metric_Pad0.98x0.95mm_HandSolder
R7: 620; R_0603_1608Metric_Pad0.98x0.95mm_HandSolder
R8: 2.8M; R_0603_1608Metric_Pad0.98x0.95mm_HandSolder
R9: 270; R_0603_1608Metric_Pad0.98x0.95mm_HandSolder
R10: 22k; R_0603_1608Metric_Pad0.98x0.95mm_HandSolder
R11: 33k; R_0603_1608Metric_Pad0.98x0.95mm_HandSolder
R12: 470; R_0603_1608Metric_Pad0.98x0.95mm_HandSolder
R13: 27.4k; R_0603_1608Metric_Pad0.98x0.95mm_HandSolder
R14, R24, R25: 10k; R_0603_1608Metric_Pad0.98x0.95mm_HandSolder
R15: 43.2k; R_0603_1608Metric_Pad0.98x0.95mm_HandSolder
R16, R26: 105k; R_0603_1608Metric_Pad0.98x0.95mm_HandSolder
R17, R18: 47k; R_0603_1608Metric_Pad0.98x0.95mm_HandSolder
R19, R21: 680k; R_0603_1608Metric_Pad0.98x0.95mm_HandSolder
R20, R22: 100k; R_0603_1608Metric_Pad0.98x0.95mm_HandSolder
R23: 52.3k; R_0603_1608Metric_Pad0.98x0.95mm_HandSolder
R27: 7.5k; R_0603_1608Metric_Pad0.98x0.95mm_HandSolder
SW1: SW_Push; SW_SPST_SKQG_WithStem
U1: ACS772ECB-400B-PFF-T; XDCR_ACS772ECB-400B-PFF-T; PARTREV 21
U2: LTC3114EFE-1_PBF; SOP65P640X110-17N
U3: STM32F030F4P6; TSSOP-20_4.4x6.5mm_P0.65mm
U4, U5: AOZ1284PI; SOP127P600X170-9N; PARTREV 0.5
U6: TLV75533PDBVR; SOT95P280X145-5N

Connections:
3.3V: C16.1, C21.2, FB1.2, J9.5, R9.1, R14.1, U3.16 (VDD); also elsewhere on the board
+5V: C8.1, C26.1, C27.1, J11.2, J12.1, L2.2, R7.1, R23.1, R25.1, U1.1 (VCC), U6.1 (IN)
+12V: C28.1, J14.2, L3.2, R26.1
+24V: C11.1, J10.2, R6.1, R8.2, U2.3 (PVOUT)
+BATT: C1.1, C2.1, C3.1, C4.1, J5.P (POS), J6.P (POS), J7.P (POS), J8.P (POS), R4.1, U1.4 (IP+)
/LED_STATUS: R12.1, U3.14 (PB1)
/NRST: J9.2, R14.2, SW1.2, U3.4 (NRST)
/SWCLK: J9.3, U3.20 (PA14)
/SWDIO: J9.4, U3.19 (PA13)
/UART_RX: J13.2, U3.9 (PA3)
/UART_TX: J13.3, U3.8 (PA2)
A_MEAS: C15.1, J12.2, R10.2, R11.1, U3.7 (PA1)
GND: C1.2, C2.2, C3.2, C4.2, C7.2, C8.2, C9.2, C10.2, C11.2, C12.2, C13.2, C15.2, C16.2, C17.2, C19.2, C21.1, C22.2, C23.2, C26.2, C27.2, C28.2, D1.1 (K), D2.1 (K), D3.1 (K), D4.1 (K), D5.1 (K), D6.2 (A), D7.2 (A), J1.2 (-), J2.2 (-), J3.2 (-), J4.2 (-), J5.N (NEG), J6.N (NEG), J7.N (NEG), J8.N (NEG), J9.1, J10.1, J11.1, J12.4, J13.1, J14.1, R1.2, R2.1, R5.2, R11.2, R13.2, R15.2, R16.2, R17.2, R18.2, R20.2, R22.2, R24.2, R27.2, SW1.1, U1.2 (GND), U2.1 (PGND), U2.8 (GND), U2.16 (MODE), U2.17 (PGND), U3.15 (VSS), U4.3 (GND), U5.3 (GND), U6.2 (GND); also elsewhere on the board
unnamed: C14.2, R13.1
unnamed: C18.1, R15.1
unnamed: C20.1, R16.1
unnamed: D1.2 (A), R3.2
unnamed: D2.2 (A), R6.2
unnamed: D3.2 (A), R7.2
unnamed: D4.2 (A), R9.2
unnamed: D5.2 (A), R12.2
unnamed: C24.2, D6.1 (K), L2.1, U4.1 (LX)
unnamed: C25.2, D7.1 (K), L3.1, U5.1 (LX)
unnamed: R10.1, U1.3 (VIOUT)
unnamed: C6.2, U2.13 (BST1)
unnamed: C5.2, U2.12 (BST2)
unnamed: R2.2, R8.1, U2.7 (FB)
unnamed: C9.1, U2.9 (LDO), U2.11 (PLDO)
unnamed: C7.1, R1.1, U2.5 (PROG)
unnamed: C6.1, L1.2, U2.15 (SW1)
unnamed: C5.1, L1.1, U2.2 (SW2)
unnamed: C14.1, U2.6 (VC)
unnamed: C24.1, U4.2 (BST)
unnamed: C18.2, U4.5 (COMP)
unnamed: R19.2, R20.1, U4.8 (EN)
unnamed: R23.2, R24.1, U4.6 (FB)
unnamed: R17.1, U4.4 (FSW)
unnamed: C22.1, U4.7 (SS)
unnamed: C25.1, U5.2 (BST)
unnamed: C20.2, U5.5 (COMP)
unnamed: R21.2, R22.1, U5.8 (EN)
unnamed: R26.2, R27.1, U5.6 (FB)
unnamed: R18.1, U5.4 (FSW)
unnamed: C23.1, U5.7 (SS)
unnamed: R25.2, U6.3 (EN)
OUTPUT_CLOCK: U3.13 (PA7); also elsewhere on the board
SDI_DATA: U3.11 (PA5); also elsewhere on the board
SER_DATA: U3.10 (PA4); also elsewhere on the board
SHIFT_CLOCK: U3.12 (PA6); also elsewhere on the board
V+_SENSED: C12.1, C17.1, C19.1, J1.1 (+), J2.1 (+), J3.1 (+), J4.1 (+), R3.1, R19.1, R21.1, U1.5 (IP-), U2.4 (RUN), U2.10 (VIN), U2.14 (PVIN), U4.9 (VIN), U5.9 (VIN)
VDDA: C10.1, C13.1, FB1.1, U3.5 (VDDA), U6.5 (OUT)
V_MEAS: J12.3, R4.2, R5.1, U3.6 (PA0)

Notes on the sheet:
11/13
Rocket power out
battery indicator: continue with n leds i think this is right...????? R = (V_batt,max - V_z,n - V_f,n) / I 25.2 V
optional but just for the stm32 if we want
Mounting holes
24V buck-boost
Voltage divider. 30 V -> 3 V. 1.5 mA draw = 20k
12V out
Also from carrier board.
Misc. UART
STM32
Voltage sense
Esc Power Ports
LPF Reference says it's optional but why not? This config gives -3db cutoff of 100 something Hz. I'd guess ardupilot is sampling at like 10s of Hz. To see this, open the lpf spice sheet on its own.
Output can source 3mA max
5V buck
Current sense
Voltage divider takes us from 5V to 3V. Sensor outputs 5V, cube takes in 3.3 max.
Jetson power out
Input from carrier board. Not optional. Current sense needs 5V.
Damped LC Filter
Rail status
Actual voltage is ~24.3V. This will be used for the Rocket
Carrier board sense out
12V buck
ST-Link
Battery input
5v to 3.3v LDO
PART PDU 2025-2026
Possible footprint: 25YXJ220M6.3X11
Pulling down FSW with a 46.6k resistor will result in a switching frequency of 1 MHz. For stability, the crossover frequency will be 1/10 of this, so 100 kHz. This is used to compute R14. Refer to page 11 of the datasheet for the formula used. NOTE: These values also depend on C15.

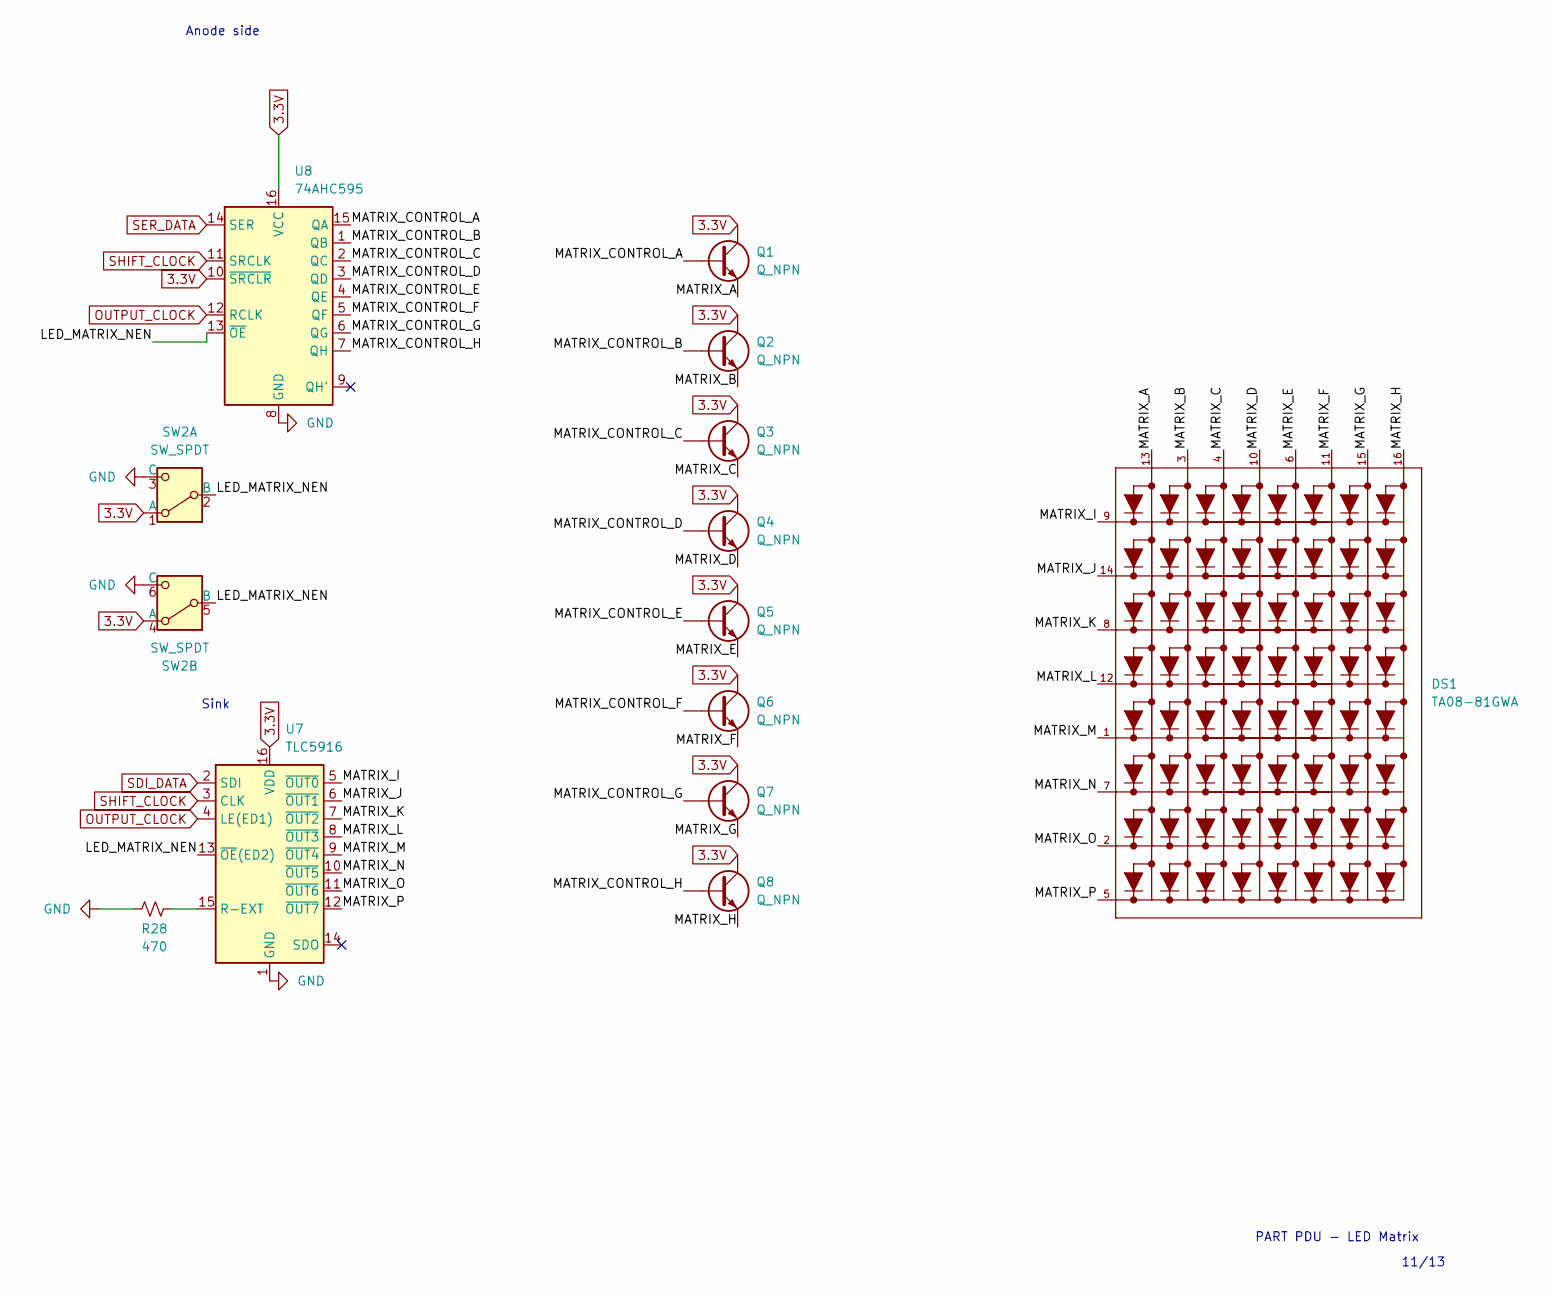
[picture p113: schematic led_matrix.kicad_sch]

Parts:
DS1: TA08-81GWA; DISPLAY_TA08-81GWA; PARTREV V.11A
Q1, Q2, Q3, Q4, Q5, Q6, Q7, Q8: Q_NPN; TSOT-23-Fixed
R28: 470; R_0603_1608Metric_Pad0.98x0.95mm_HandSolder
SW2: SW_SPDT; JS202011SCQN
U7: TLC5916; DIP-16_W7.62mm
U8: 74AHC595; DIP-16_W7.62mm

Connections:
3.3V: Q1.C, Q2.C, Q3.C, Q4.C, Q5.C, Q6.C, Q7.C, Q8.C, SW2.1 (A), SW2.4 (A), U7.16 (VDD), U8.10 (~SRCLR), U8.16 (VCC); also elsewhere on the board
/led_matrix/LED_MATRIX_NEN: SW2.2 (B), SW2.5 (B), U7.13 (~OE(ED2)), U8.13 (~OE)
/led_matrix/MATRIX_A: DS1.13, Q1.E
/led_matrix/MATRIX_B: DS1.3, Q2.E
/led_matrix/MATRIX_C: DS1.4, Q3.E
/led_matrix/MATRIX_CONTROL_A: Q1.B, U8.15 (QA)
/led_matrix/MATRIX_CONTROL_B: Q2.B, U8.1 (QB)
/led_matrix/MATRIX_CONTROL_C: Q3.B, U8.2 (QC)
/led_matrix/MATRIX_CONTROL_D: Q4.B, U8.3 (QD)
/led_matrix/MATRIX_CONTROL_E: Q5.B, U8.4 (QE)
/led_matrix/MATRIX_CONTROL_F: Q6.B, U8.5 (QF)
/led_matrix/MATRIX_CONTROL_G: Q7.B, U8.6 (QG)
/led_matrix/MATRIX_CONTROL_H: Q8.B, U8.7 (QH)
/led_matrix/MATRIX_D: DS1.10, Q4.E
/led_matrix/MATRIX_E: DS1.6, Q5.E
/led_matrix/MATRIX_F: DS1.11, Q6.E
/led_matrix/MATRIX_G: DS1.15, Q7.E
/led_matrix/MATRIX_H: DS1.16, Q8.E
/led_matrix/MATRIX_I: DS1.9, U7.5 (~OUT0)
/led_matrix/MATRIX_J: DS1.14, U7.6 (~OUT1)
/led_matrix/MATRIX_K: DS1.8, U7.7 (~OUT2)
/led_matrix/MATRIX_L: DS1.12, U7.8 (~OUT3)
/led_matrix/MATRIX_M: DS1.1, U7.9 (~OUT4)
/led_matrix/MATRIX_N: DS1.7, U7.10 (~OUT5)
/led_matrix/MATRIX_O: DS1.2, U7.11 (~OUT6)
/led_matrix/MATRIX_P: DS1.5, U7.12 (~OUT7)
GND: R28.1, SW2.3 (C), SW2.6 (C), U7.1 (GND), U8.8 (GND); also elsewhere on the board
unnamed: R28.2, U7.15 (R-EXT)
OUTPUT_CLOCK: U7.4 (LE(ED1)), U8.12 (RCLK); also elsewhere on the board
SDI_DATA: U7.2 (SDI); also elsewhere on the board
SER_DATA: U8.14 (SER); also elsewhere on the board
SHIFT_CLOCK: U7.3 (CLK), U8.11 (SRCLK); also elsewhere on the board

Notes on the sheet:
11/13
PART PDU - LED Matrix
Sink
Anode side

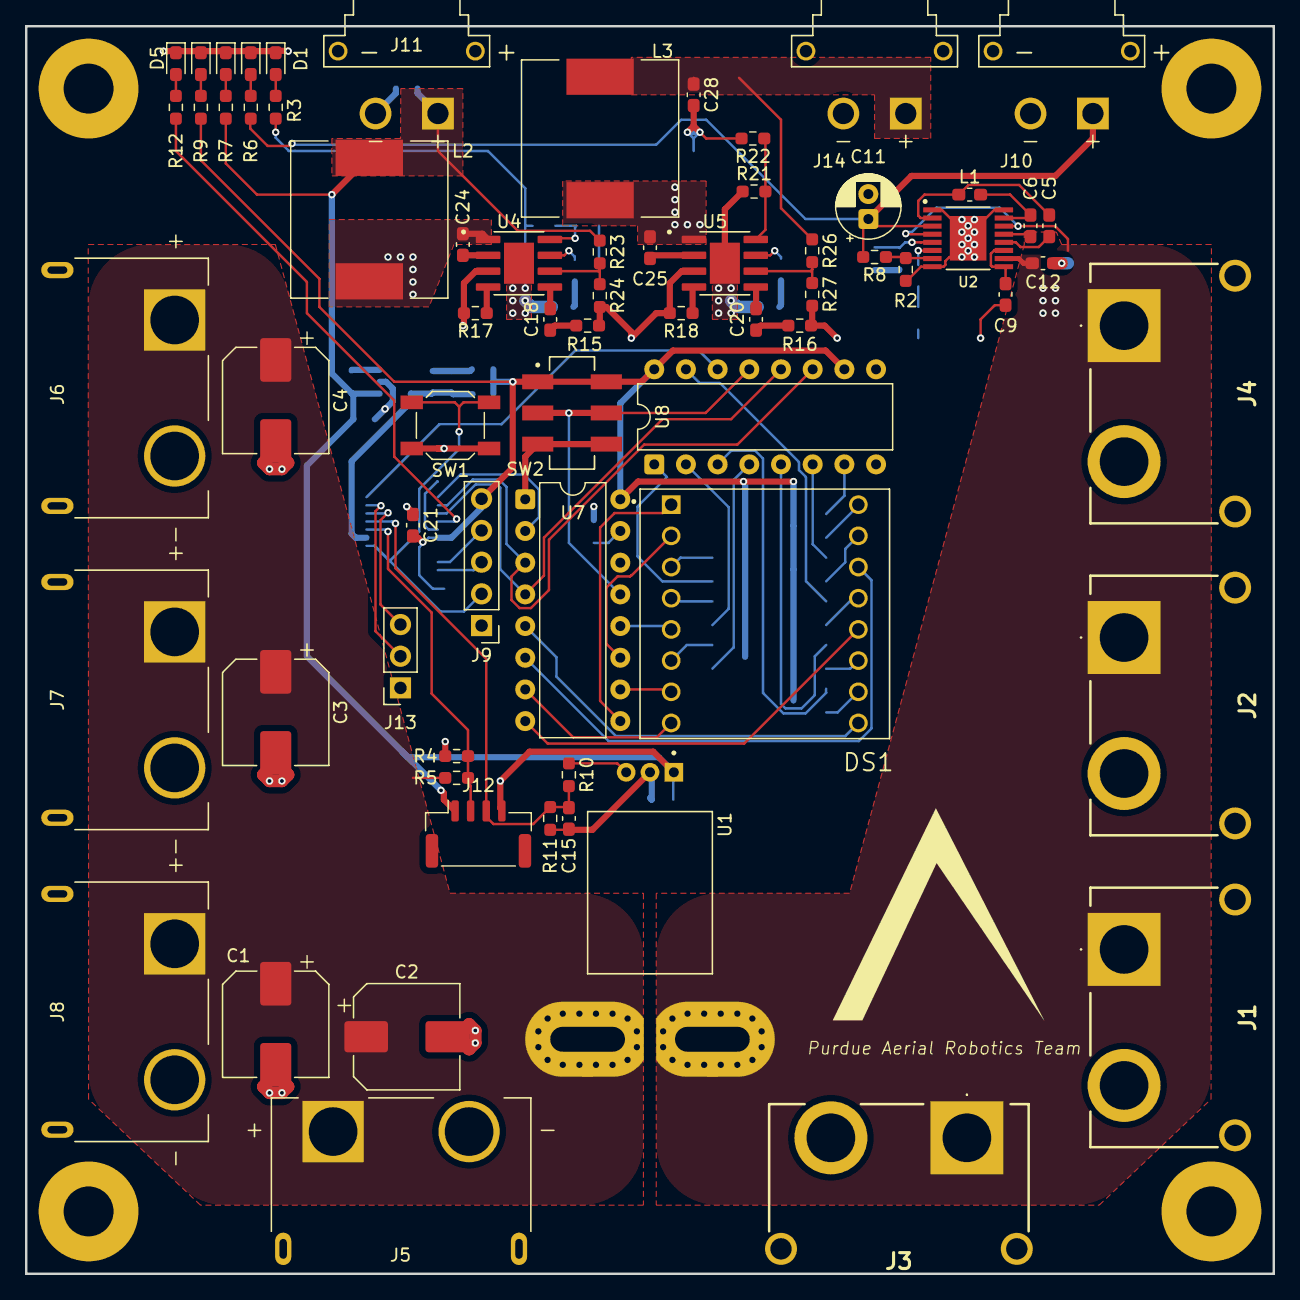
[picture p114: board pdb.kicad_pcb from above]

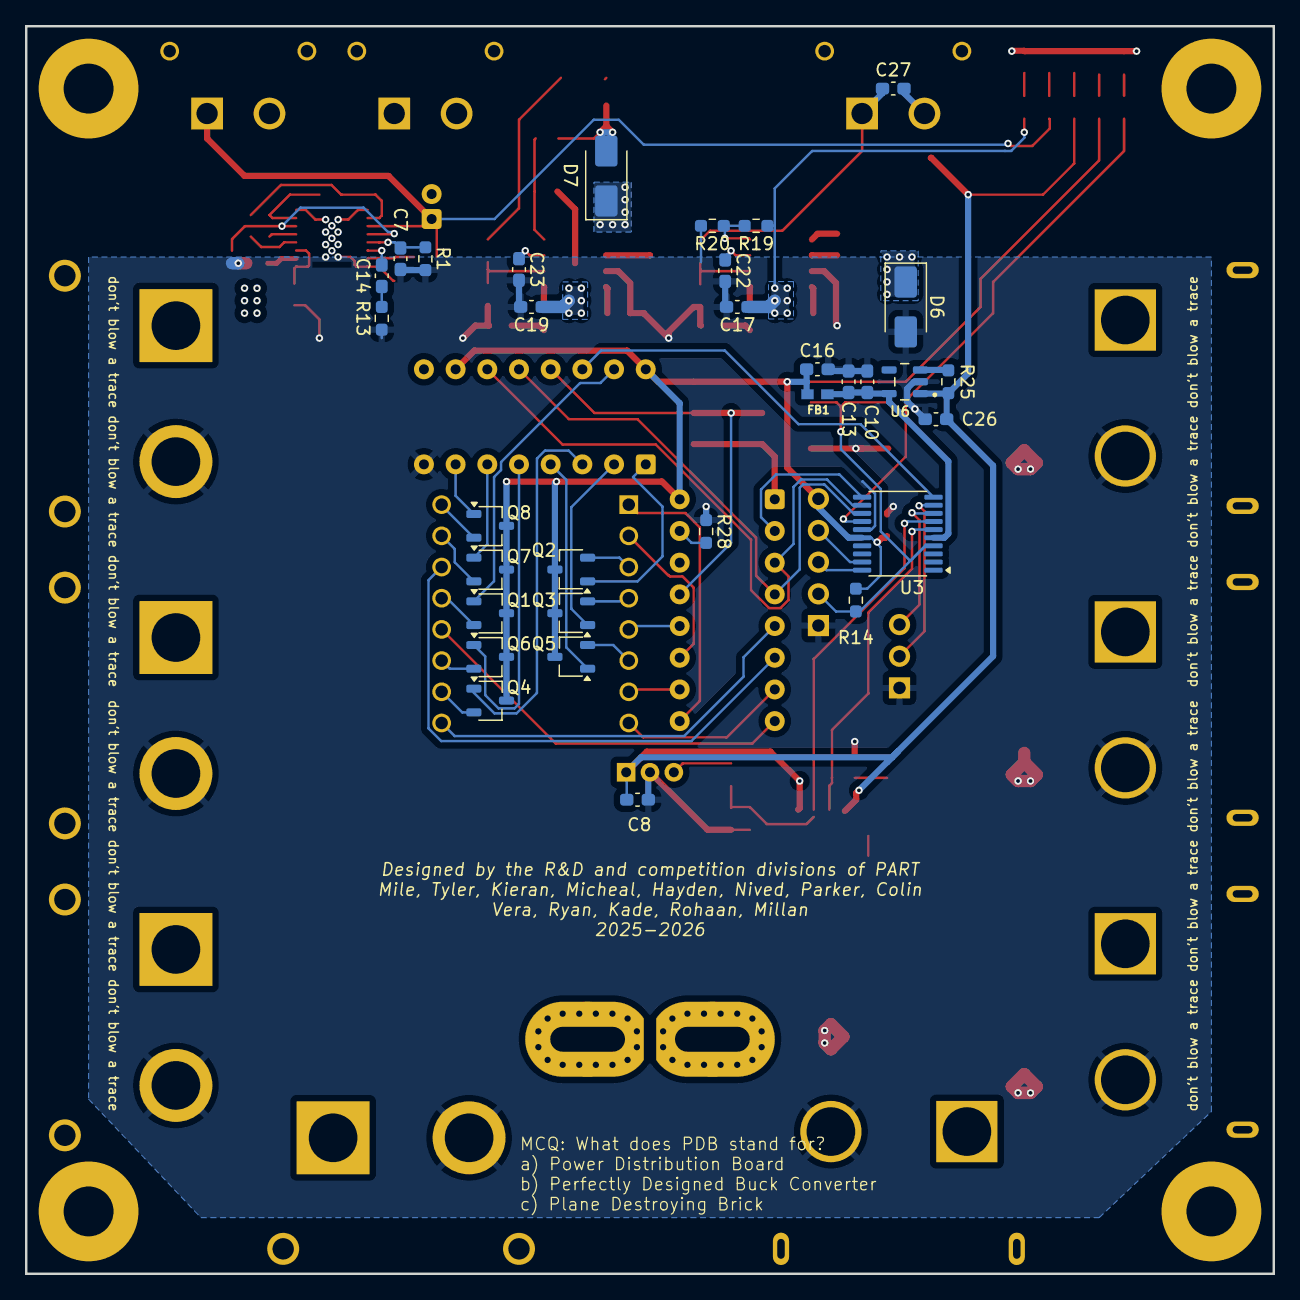
[picture p115: board pdb.kicad_pcb from below]

Board: 4 copper layers, 100.0 x 100.0 mm, 104 parts (32 on the bottom side), 78 nets.
