javierveras/projectav-telemetry-pdb-2026/hardware/refferences/kicad-refferences/CurrentSensor/sensor_corrente.kicad_pcb

## KiCad design hardware/refferences/kicad-refferences/CurrentSensor/sensor_corrente.kicad_pcb (2026-09-18)

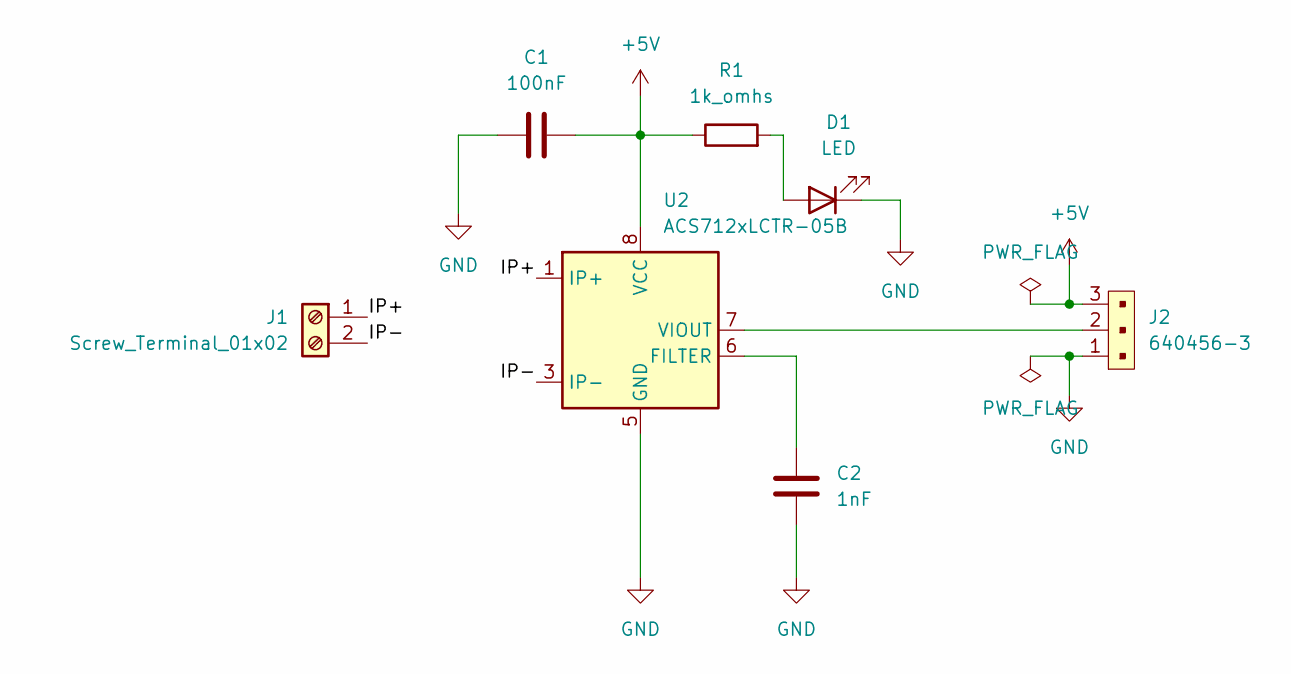
[picture p116: schematic sensor_corrente.kicad_sch]

Parts:
C1: 100nF; C_0805_2012Metric
C2: 1nF; C_0805_2012Metric
D1: LED; LED_0805_2012Metric
J1: Screw_Terminal_01x02; TerminalBlock_Phoenix_MKDS-1,5-2-5.08_1x02_P5.08mm_Horizont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
J2: 640456-3; PinHeader_1x3_P2.54_Drill1.1mm; MPN 640456-3; Digi-Key_PN A19470-ND
R1: 1k_omhs; R_0805_2012Metric
U2: ACS712xLCTR-05B; SOIC-8_3.9x4.9mm_P1.27mm

Connections:
+5V: C1.2, J2.3, R1.1, U2.8 (VCC)
/IP+: J1.1, U2.1 (IP+), U2.2 (IP+)
/IP-: J1.2, U2.3 (IP-), U2.4 (IP-)
GND: C1.1, C2.2, D1.1 (K), J2.1, U2.5 (GND)
unnamed: D1.2 (A), R1.2
unnamed: C2.1, U2.6 (FILTER)
unnamed: J2.2, U2.7 (VIOUT)

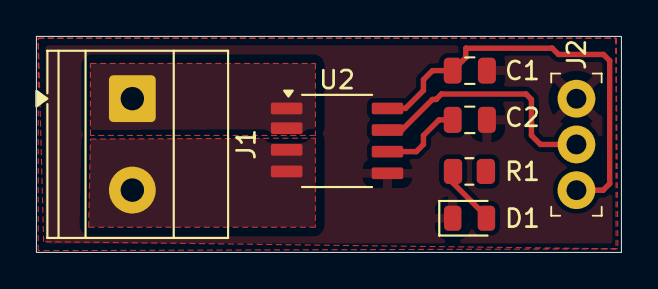
[picture p117: board sensor_corrente.kicad_pcb from above]

Board: 2 copper layers, 32.5 x 12.0 mm, 7 parts (0 on the bottom side), 7 nets.
