javierveras/projectav-telemetry-pdb-2026/hardware/mark-I/telemetry-motherboard/telemetry_mark_I.kicad_pcb

## KiCad design hardware/mark-I/telemetry-motherboard/telemetry_mark_I.kicad_pcb (2026-09-23, an earlier design)

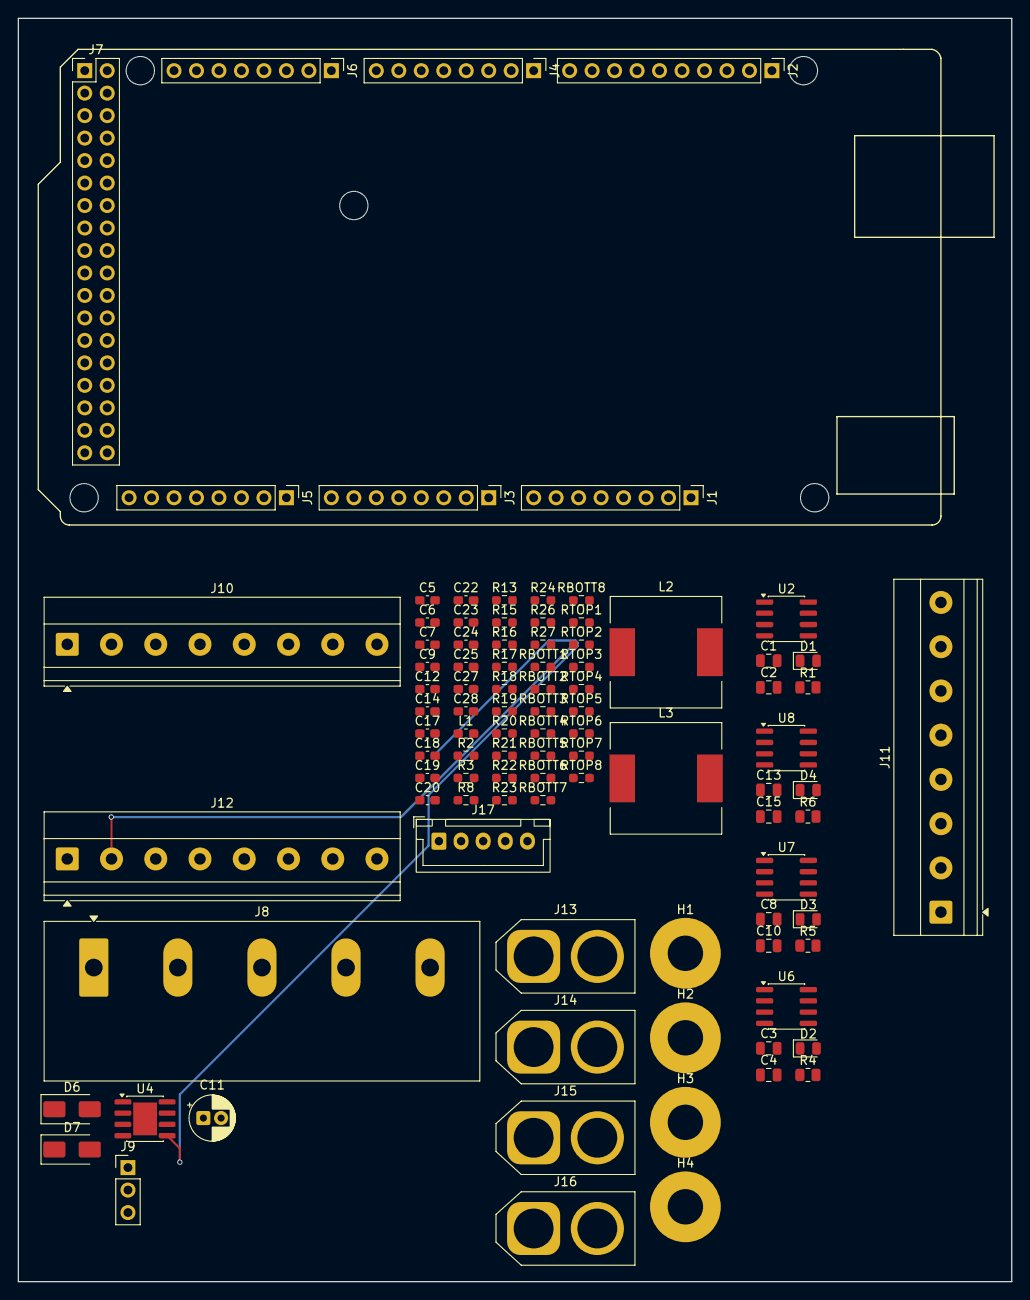
[picture p118: board hardware/mark-I/telemetry-motherboard/telemetry_mark_I.kicad_pcb from above]

Board: 2 copper layers, 112.2 x 142.8 mm, 101 parts (0 on the bottom side), 56 nets.

Parts:
C1, C3, C8, C13: 100nF; C_0805_2012Metric
C2, C4, C10, C15: 1nF; C_0805_2012Metric
C5, C6: 68n; C_0603_1608Metric_Pad1.08x0.95mm_HandSolder
C7: 33n; C_0603_1608Metric_Pad1.08x0.95mm_HandSolder
C9: 4.7u; C_0603_1608Metric_Pad1.08x0.95mm_HandSolder
C11: 30u; CP_Radial_D5.0mm_P2.00mm
C12, C17, C19, C27, C28: 10u; C_0603_1608Metric_Pad1.08x0.95mm_HandSolder
C14: 4.7n; C_0603_1608Metric_Pad1.08x0.95mm_HandSolder
C18, C20: 0.3n; C_0603_1608Metric_Pad1.08x0.95mm_HandSolder
C22, C23: 1n; C_0603_1608Metric_Pad1.08x0.95mm_HandSolder
C24, C25: 100n; C_0603_1608Metric_Pad1.08x0.95mm_HandSolder
D1, D2, D3, D4: LED; LED_0805_2012Metric
D6, D7: SS54; D_SMA
H1, H2, H3, H4: MountingHole; MountingHole_4mm_Pad
J1: Power; PinHeader_1x08_P2.54mm_Vertical
J2: PWM; PinHeader_1x10_P2.54mm_Vertical
J3, J5: Analog; PinHeader_1x08_P2.54mm_Vertical
J4: PWM; PinHeader_1x08_P2.54mm_Vertical
J6: Communication; PinHeader_1x08_P2.54mm_Vertical
J7: Digital; PinHeader_2x18_P2.54mm_Vertical
J8: Input_Terminal; TerminalBlock_Ningbo-Kagnex_HB9500_1x05_P9.5mm
J9: Temp_Sensor_Header; PinHeader_1x03_P2.54mm_Vertical
J10: 5V_BUS; TerminalBlock_Phoenix_MKDS-1,5-8_1x08_P5.00mm_Horizontal
J11: 12V_BUS; TerminalBlock_Phoenix_MKDS-1,5-8_1x08_P5.00mm_Horizontal
J12: 24V_BUS; TerminalBlock_Phoenix_MKDS-1,5-8_1x08_P5.00mm_Horizontal
J13, J14, J15, J16: Conn_01x02_Socket; AMASS_XT60-F_1x02_P7.20mm_Vertical
J17: BMS_Header; JST_XH_B5B-XH-A_1x05_P2.50mm_Vertical
L1: 6.8u; L_0603_1608Metric_Pad1.05x0.95mm_HandSolder
L2, L3: 22u; L_12x12mm_H8mm
MH1, MH2, MH3, MH5, MH6: MountingHole_3.2mm
R1, R4, R5, R6: 1k; R_0805_2012Metric
R2: 20k; R_0603_1608Metric_Pad0.98x0.95mm_HandSolder
R3: 120k; R_0603_1608Metric_Pad0.98x0.95mm_HandSolder
R8: 2.8M; R_0603_1608Metric_Pad0.98x0.95mm_HandSolder
R13: 27.4k; R_0603_1608Metric_Pad0.98x0.95mm_HandSolder
R15: 43.2k; R_0603_1608Metric_Pad0.98x0.95mm_HandSolder
R16, R26: 105k; R_0603_1608Metric_Pad0.98x0.95mm_HandSolder
R17, R18: 47k; R_0603_1608Metric_Pad0.98x0.95mm_HandSolder
R19, R21: 680k; R_0603_1608Metric_Pad0.98x0.95mm_HandSolder
R20, R22: 100k; R_0603_1608Metric_Pad0.98x0.95mm_HandSolder
R23: 52.3k; R_0603_1608Metric_Pad0.98x0.95mm_HandSolder
R24: 10k; R_0603_1608Metric_Pad0.98x0.95mm_HandSolder
R27: 7.5k; R_0603_1608Metric_Pad0.98x0.95mm_HandSolder
RBOTT1, RBOTT2, RBOTT3, RBOTT4: 2k; R_0603_1608Metric_Pad0.98x0.95mm_HandSolder
RBOTT5, RBOTT6, RBOTT7, RBOTT8: 10K; R_0603_1608Metric_Pad0.98x0.95mm_HandSolder
RTOP1, RTOP2, RTOP3, RTOP4: 18k; R_0603_1608Metric_Pad0.98x0.95mm_HandSolder
RTOP5, RTOP6, RTOP7, RTOP8: 47K; R_0603_1608Metric_Pad0.98x0.95mm_HandSolder
U2, U6, U7, U8: ACS712xLCTR-05B; SOIC-8_3.9x4.9mm_P1.27mm
U4: AOZ1284PI; SOIC-8-1EP_3.9x4.9mm_P1.27mm_EP2.71x3.7mm

Connections:
5V_MEASS: J9.1, J10.1, J10.2, J10.3, J10.4, J10.5, J10.6, J10.7, J10.8, RTOP4.1, U2.3 (IP-), U2.4 (IP-)
12V_MEASS: J11.1, J11.2, J11.3, J11.4, J11.5, J11.6, J11.7, J11.8, RTOP1.1, U6.3 (IP-), U6.4 (IP-)
24V_MEASS: J12.1, J12.2, J12.3, J12.4, J12.5, J12.6, J12.7, J12.8, RTOP2.1, U7.3 (IP-), U7.4 (IP-)
+5V: C1.2, C3.2, C8.2, C13.2, C27.1, J1.5, J7.35, J7.36, L2.2, R1.1, R4.1, R5.1, R6.1, R23.1, U2.1 (IP+), U2.2 (IP+), U2.8 (VCC), U6.8 (VCC), U7.8 (VCC), U8.8 (VCC)
+12V: C28.1, L3.2, R26.1, U6.1 (IP+), U6.2 (IP+)
+24V: C11.1, R8.2, U7.1 (IP+), U7.2 (IP+)
/5V_CURRENT: J3.1, U2.7 (VIOUT)
/5V_VOLTAGE: RBOTT4.1, RTOP4.2
/12V_CURRENT: J3.2, U6.7 (VIOUT)
/12V_VOLTAGE: RBOTT1.1, RTOP1.2
/24V_CURRENT: J3.3, U7.7 (VIOUT)
/24V_VOLTAGE: RBOTT2.1, RTOP2.2
/BATT_CURRENT: J3.4, U8.7 (VIOUT)
/BATT_VOLTAGE: RBOTT3.1, RTOP3.2
/MEASS_CELL1: J3.6, RBOTT5.1, RTOP5.2
/MEASS_CELL2: J3.7, RBOTT7.1, RTOP7.2
/MEASS_CELL3: J3.8, RBOTT6.1, RTOP6.2
/MEASS_CELL4: J5.1, RBOTT8.1, RTOP8.2
/RAW_BATT(15-5): C17.1, J8.1, R19.1, U4.9 (VIN)
/RAW_BATT(15-12): C19.1, J8.2, R21.1
/RAW_BATT(15-24): C12.1, J8.3
/RAW_BATT(15-ESCs): J8.4, U8.1 (IP+), U8.2 (IP+)
/SCL/21: J2.1, J6.8
/SDA/20: J2.2, J6.7
/TEMP_READING: J3.5, J9.2
BATT_MEASS: J13.1, J14.1, J15.1, J16.1, RTOP3.1, U8.3 (IP-), U8.4 (IP-)
GND: C1.1, C2.2, C3.1, C4.2, C7.2, C8.1, C9.2, C10.2, C11.2, C12.2, C13.1, C15.2, C17.2, C19.2, C22.2, C23.2, C27.2, C28.2, D1.1 (K), D2.1 (K), D3.1 (K), D4.1 (K), D6.2 (A), D7.2 (A), J1.6, J1.7, J2.4, J7.1, J7.2, J9.3, J13.2, J14.2, J15.2, J16.2, R2.2, R3.1, R13.2, R15.2, R16.2, R17.2, R18.2, R20.2, R22.2, R24.2, R27.2, RBOTT1.2, RBOTT2.2, RBOTT3.2, RBOTT4.2, RBOTT5.2, RBOTT6.2, RBOTT7.2, RBOTT8.2, U2.5 (GND), U4.3 (GND), U6.5 (GND), U7.5 (GND), U8.5 (GND)
unnamed: C14.2, R13.1
unnamed: C18.1, R15.1
unnamed: C20.1, R16.1
unnamed: D1.2 (A), R1.2
unnamed: D2.2 (A), R4.2
unnamed: D3.2 (A), R5.2
unnamed: D4.2 (A), R6.2
unnamed: C24.2, D6.1 (K), L2.1, U4.1 (LX)
unnamed: C25.2, D7.1 (K), L3.1
unnamed: C2.1, U2.6 (FILTER)
unnamed: R3.2, R8.1
unnamed: C7.1, R2.1
unnamed: C6.1, L1.2
unnamed: C5.1, L1.1
unnamed: C24.1, U4.2 (BST)
unnamed: C18.2, U4.5 (COMP)
unnamed: R19.2, R20.1, U4.8 (EN)
unnamed: R23.2, R24.1, U4.6 (FB)
unnamed: R17.1, U4.4 (FSW)
unnamed: C22.1, U4.7 (SS)
unnamed: R21.2, R22.1
unnamed: R26.2, R27.1
unnamed: C4.1, U6.6 (FILTER)
unnamed: C10.1, U7.6 (FILTER)
unnamed: C15.1, U8.6 (FILTER)
RAW_CELL1: J17.1, RTOP5.1
RAW_CELL2: J17.2, RTOP7.1
RAW_CELL3: J17.3, RTOP6.1
RAW_CELL4: J17.4, RTOP8.1
