javierveras/projectav-telemetry-pdb-2026/(commit log)

2026-09-18 Initial File Push
    [24buckboost.kicad_sch, 5vbuck.kicad_sch, ACS772ECB-400B-PFF-T.step, AOZ1284PI.step, EDI2CAP.CFG, JS202011SCQN.step, LI0603G121R-10.step, LTC3114EFE-1_PBF.step]
2026-09-18 Pin Config
2026-09-23 Abstracted Sensor Class
2026-09-23 Abstracted Temperature Sensor Method
2026-09-23 borre arm
2026-09-23 anadi arm
2026-09-23 Deleted bms.png
2026-09-23 Changed routes
    [telemetry_mark_I.kicad_pcb]
2026-09-24 Finished BMS Integration for Initial Testing
2026-09-24 Changed Buzzar Variable name
    [constants.h, main.cpp]
2026-09-29 Work on fault abstraction
    [current_sensor.kicad_sch, telemetry_mark_I.kicad_sch]
2026-10-06 LED finished
    [bms.kicad_pcb, bms.kicad_sch]
2026-10-07 Added abstracted buzzer function
    [constants.h, main.cpp, sensors.h]
2026-10-07 Fixed for bms test
    [sensors.h]
2026-10-07 New commit
    [bms.kicad_pcb, bms.kicad_sch, telemetry.kicad_pcb, telemetry.kicad_sch, telemetry_mark_I.kicad_pcb, telemetry_mark_I.kicad_sch]
2026-10-14 Added Sensors & LCD
